MetropoliaMotorsport/Nodes/README.md

# Nodes
New Power + Analog nodes for HPF24
