MetropoliaMotorsport/Nodes/Datasheet_Nodes/size1.png

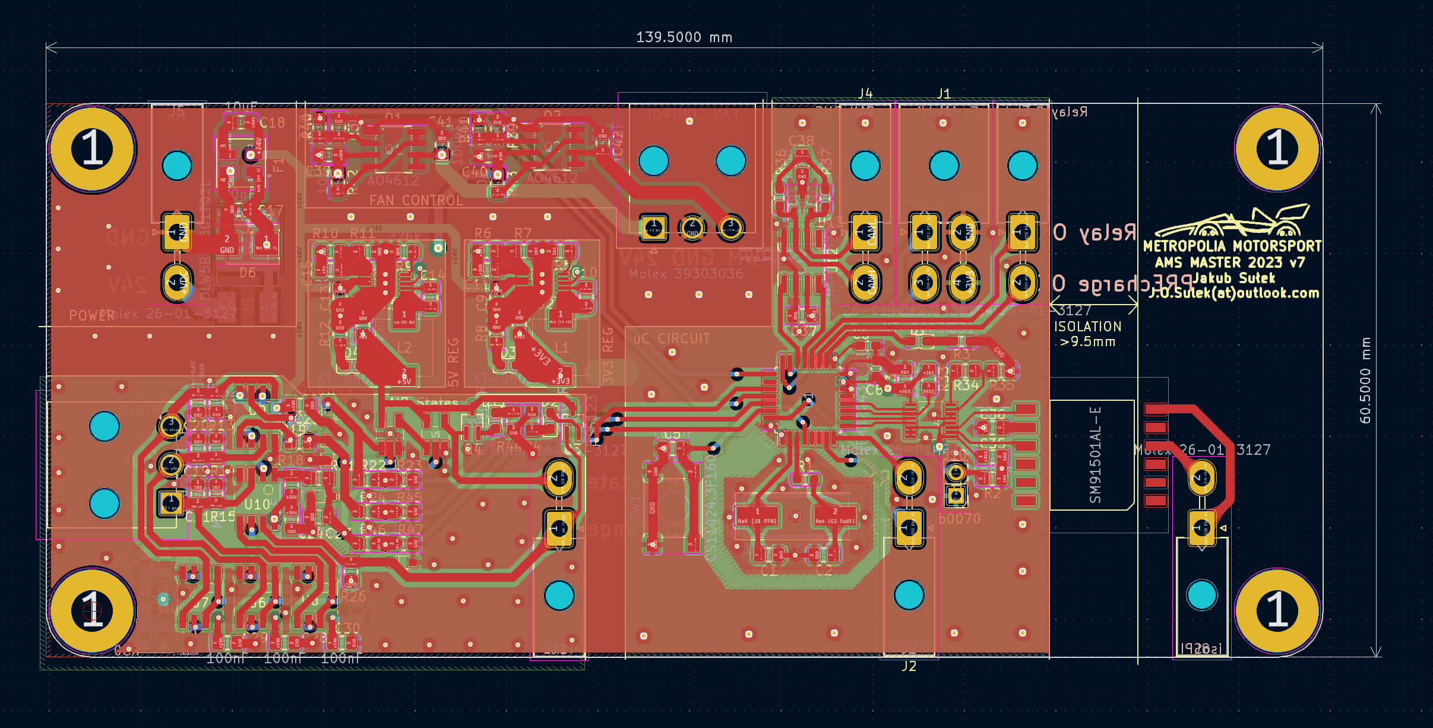
Datasheet_Nodes/size1.png
