MetropoliaMotorsport/Nodes/Datasheet_Nodes/size2.png

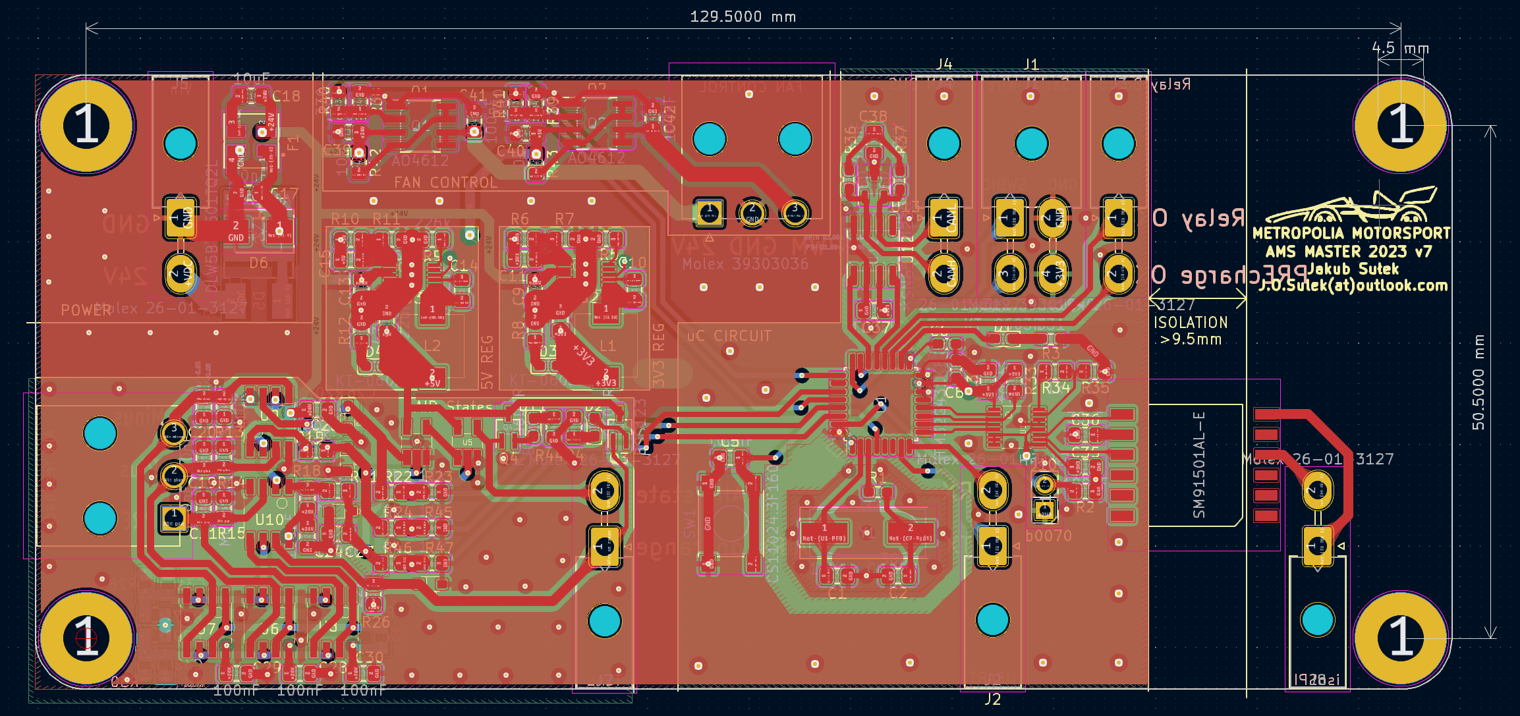
Datasheet_Nodes/size2.png
