MetropoliaMotorsport/Nodes/Nodes/Nodes.kicad_pcb

## KiCad design Nodes/Nodes.kicad_pcb (2024-12-06)

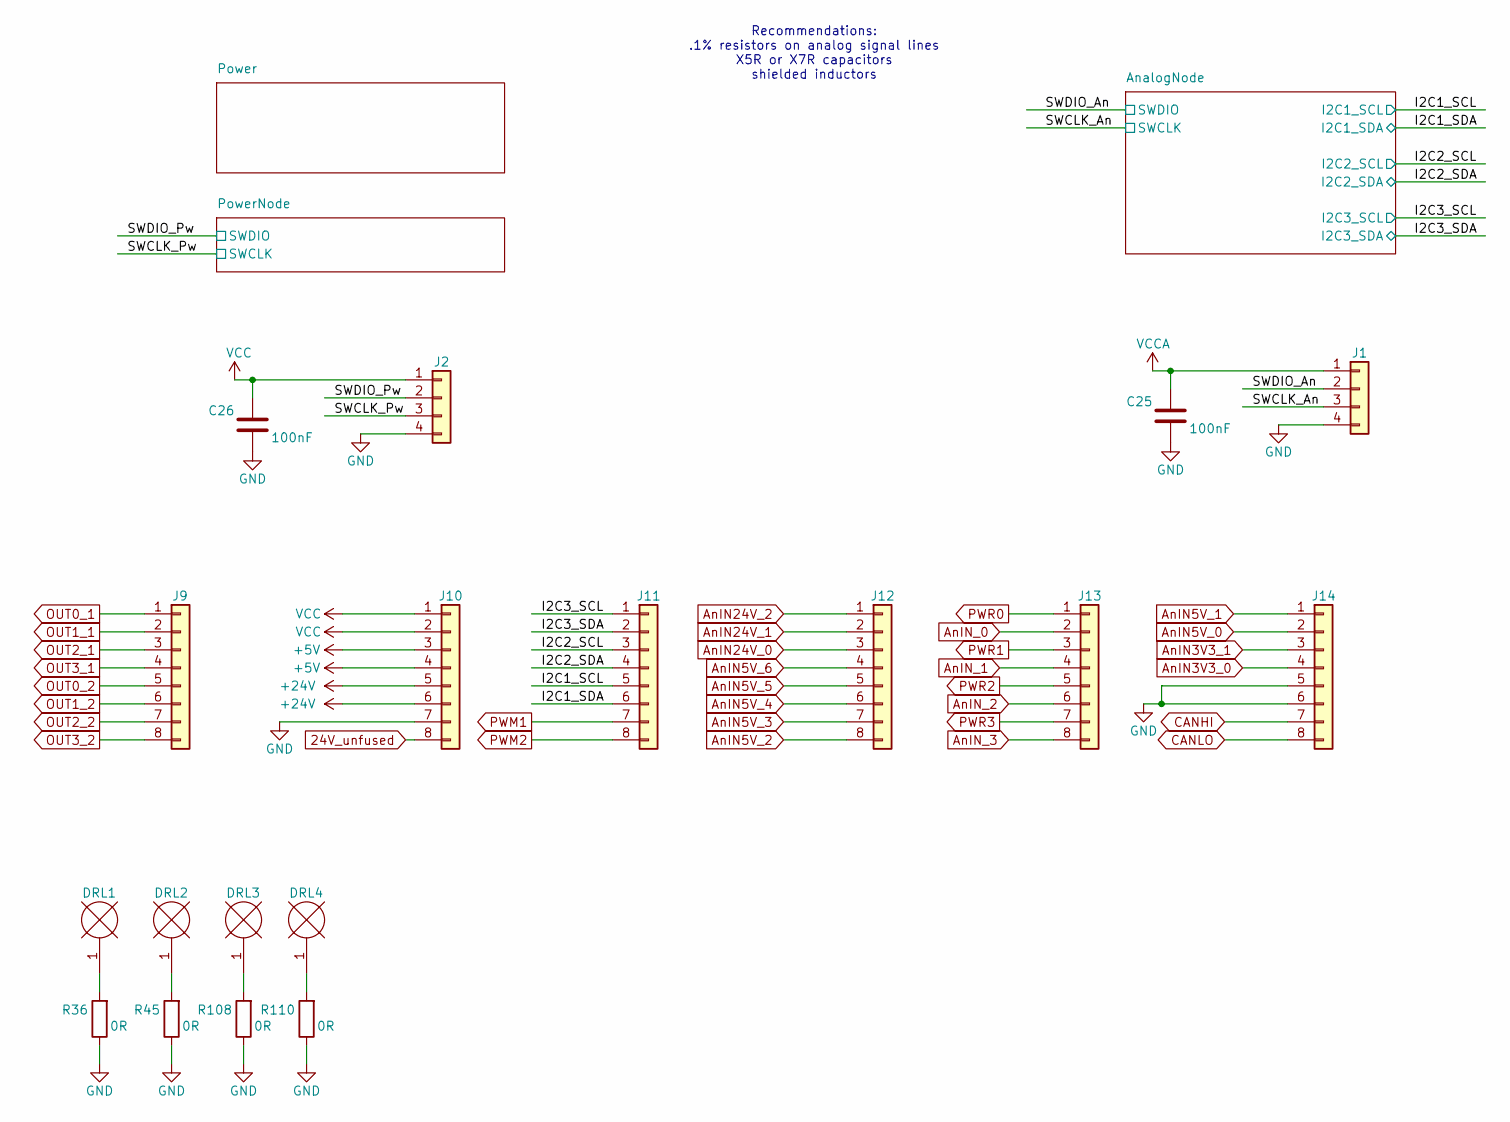
[picture p48: schematic Nodes.kicad_sch, Main]

Parts:
C25, C26: 100nF; C_0805_2012Metric_Pad1.18x1.45mm_HandSolder; TOLERANCE (FILL IN AS +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 10%
DRL1, DRL2, DRL3, DRL4: HOLE4.28.4; MountingHole_4.3mm_M4_Pad
J1, J2: Conn_01x04; PinSocket_1x04_P2.54mm_Vertical
J9, J10, J11, J12, J13, J14: Conn_01x08; PinHeader_1x08_P2.54mm_Vertical
R36, R45, R108, R110: 0R; R_0805_2012Metric_Pad1.20x1.40mm_HandSolder

Connections:
24V_unfused: J10.8; also elsewhere on the board
+5V: J10.3, J10.4; also elsewhere on the board
+24V: J10.5, J10.6; also elsewhere on the board
/I2C1_SCL: J11.5; also elsewhere on the board
/I2C1_SDA: J11.6; also elsewhere on the board
/I2C2_SCL: J11.3; also elsewhere on the board
/I2C2_SDA: J11.4; also elsewhere on the board
/I2C3_SCL: J11.1; also elsewhere on the board
/I2C3_SDA: J11.2; also elsewhere on the board
/SWCLK_An: J1.3; also elsewhere on the board
/SWCLK_Pw: J2.3; also elsewhere on the board
/SWDIO_An: J1.2; also elsewhere on the board
/SWDIO_Pw: J2.2; also elsewhere on the board
AnIN3V3_0: J14.4; also elsewhere on the board
AnIN3V3_1: J14.3; also elsewhere on the board
AnIN5V_0: J14.2; also elsewhere on the board
AnIN5V_1: J14.1; also elsewhere on the board
AnIN5V_2: J12.8; also elsewhere on the board
AnIN5V_3: J12.7; also elsewhere on the board
AnIN5V_4: J12.6; also elsewhere on the board
AnIN5V_5: J12.5; also elsewhere on the board
AnIN5V_6: J12.4; also elsewhere on the board
AnIN24V_0: J12.3; also elsewhere on the board
AnIN24V_1: J12.2; also elsewhere on the board
AnIN24V_2: J12.1; also elsewhere on the board
AnIN_0: J13.2; also elsewhere on the board
AnIN_1: J13.4; also elsewhere on the board
AnIN_2: J13.6; also elsewhere on the board
AnIN_3: J13.8; also elsewhere on the board
CANHI: J14.7; also elsewhere on the board
CANLO: J14.8; also elsewhere on the board
GND: C25.2, C26.2, J1.4, J2.4, J10.7, J14.5, J14.6, R36.1, R45.1, R108.1, R110.1; also elsewhere on the board
unnamed: DRL1.1, R36.2
unnamed: DRL2.1, R45.2
unnamed: DRL3.1, R108.2
unnamed: DRL4.1, R110.2
OUT0_1: J9.1; also elsewhere on the board
OUT0_2: J9.5; also elsewhere on the board
OUT1_1: J9.2; also elsewhere on the board
OUT1_2: J9.6; also elsewhere on the board
OUT2_1: J9.3; also elsewhere on the board
OUT2_2: J9.7; also elsewhere on the board
OUT3_1: J9.4; also elsewhere on the board
OUT3_2: J9.8; also elsewhere on the board
PWM1: J11.7; also elsewhere on the board
PWM2: J11.8; also elsewhere on the board
PWR0: J13.1; also elsewhere on the board
PWR1: J13.3; also elsewhere on the board
PWR2: J13.5; also elsewhere on the board
PWR3: J13.7; also elsewhere on the board
VCC: C26.1, J2.1, J10.1, J10.2; also elsewhere on the board
VCCA: C25.1, J1.1; also elsewhere on the board

Notes on the sheet:
Recommendations: .1% resistors on analog signal lines X5R or X7R capacitors shielded inductors
${REVISION}

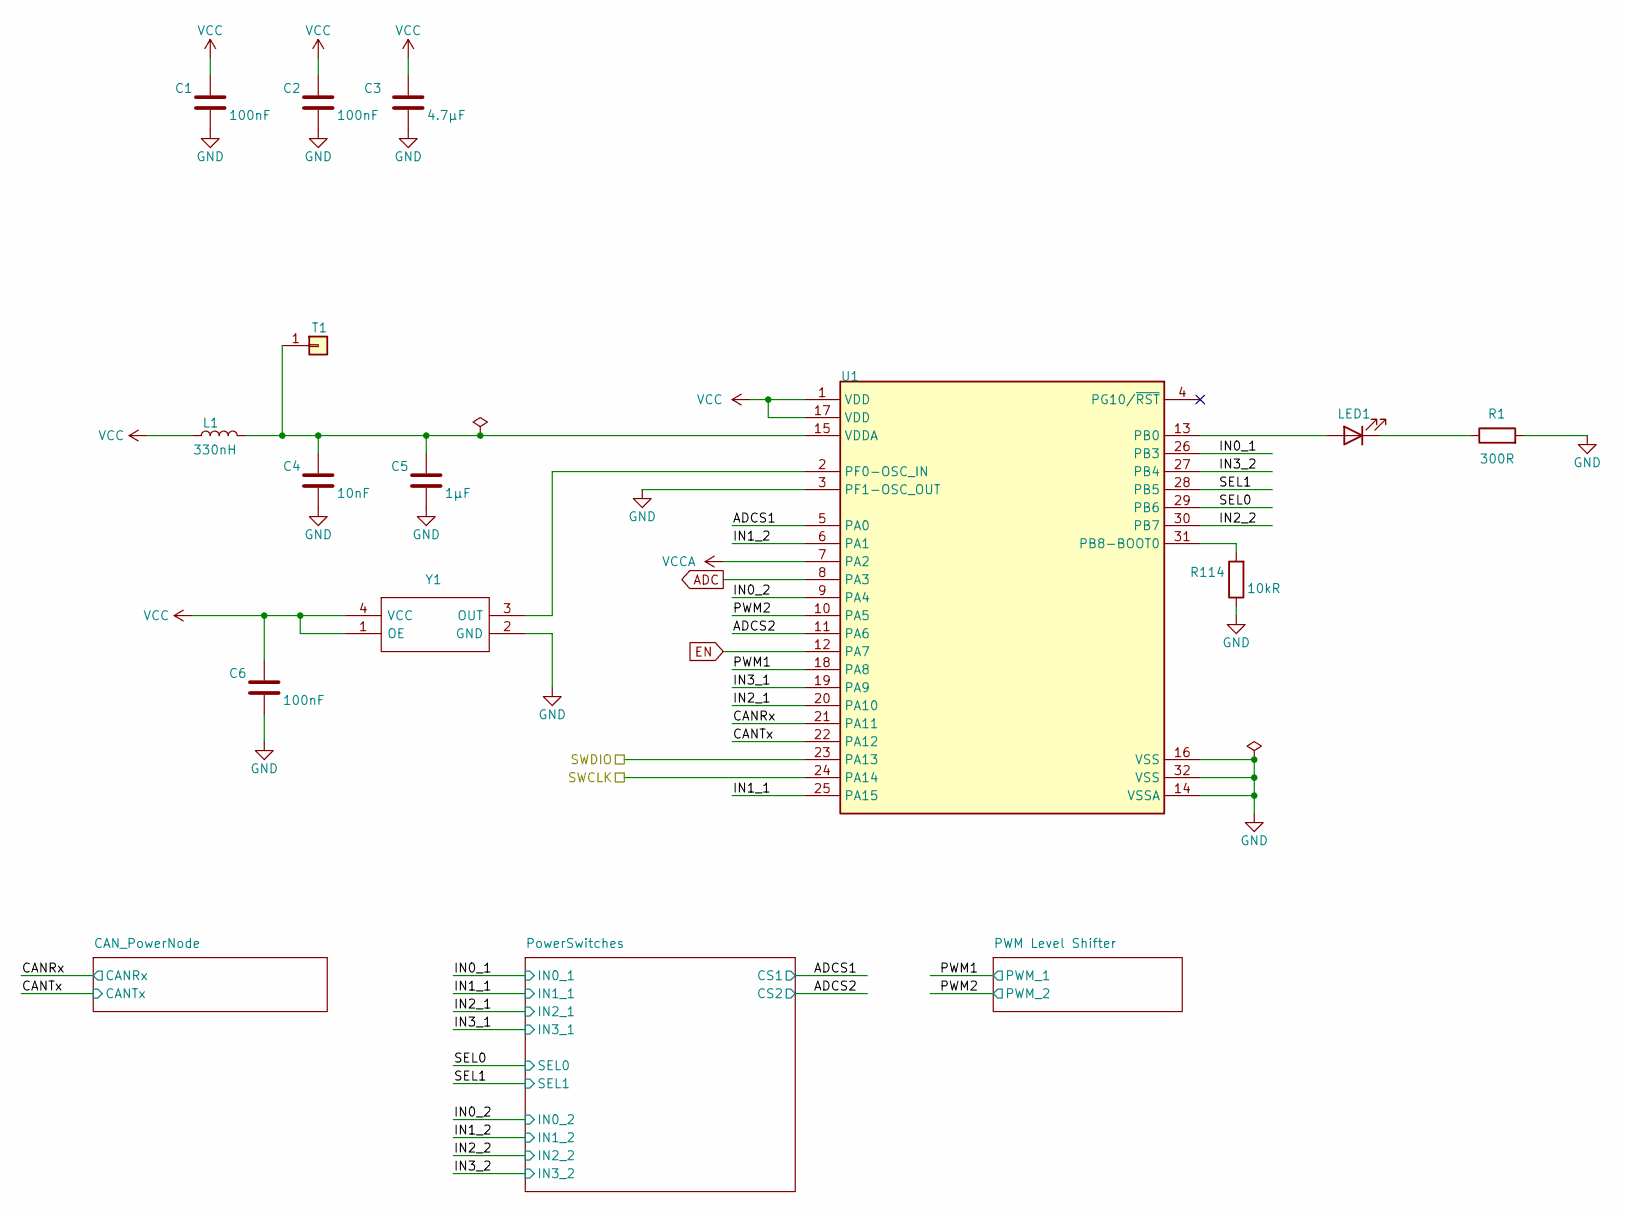
[picture p49: schematic PowerNode.kicad_sch, Power Node]

Parts:
C1, C2, C6: 100nF; C_0805_2012Metric_Pad1.18x1.45mm_HandSolder; TOLERANCE (FILL IN AS +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 10%
C3: 4.7µF; C_0805_2012Metric_Pad1.18x1.45mm_HandSolder; TOLERANCE (FILL IN AS +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 10%
C4: 10nF; C_0805_2012Metric_Pad1.18x1.45mm_HandSolder; TOLERANCE (FILL IN AS +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 10%
C5: 1µF; C_0805_2012Metric_Pad1.18x1.45mm_HandSolder; TOLERANCE (FILL IN AS +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 10%
L1: 330nH; L_0805_2012Metric_Pad1.15x1.40mm_HandSolder; TOLERANCE 20%
LED1: SML-210VTT86; LED_0805_2012Metric_Pad1.15x1.40mm_HandSolder; FORWARD VOLTAGE 2V; REVERSE VOLTAGE 4V; MANUFACTURER PART NUMBER SML-210VTT86; MOUSER DESCRIPTION Standard LEDs - SMD RED SMD TRANS LENS
R1: 300R; R_0805_2012Metric_Pad1.20x1.40mm_HandSolder; POWER RATING 400mW; TOLERANCE 5%
R114: 10kR; R_0805_2012Metric_Pad1.20x1.40mm_HandSolder
T1: Conn_01x01; TestPoint_THTPad_D1.5mm_Drill0.7mm
U1: STM32G431KBT6; FP-LQFP32-5V-IPC_B
Y1: SG-8018CE_8.0000M-TJHPA3; SG8018CE80000MTJHPA3; Mouser Part Number 732-CE8M-TJHPA3

Connections:
/PowerNode/ADCS1: U1.5 (PA0); also elsewhere on the board
/PowerNode/ADCS2: U1.11 (PA6); also elsewhere on the board
/PowerNode/CANRx: U1.21 (PA11); also elsewhere on the board
/PowerNode/CANTx: U1.22 (PA12); also elsewhere on the board
/PowerNode/IN0_1: U1.26 (PB3); also elsewhere on the board
/PowerNode/IN0_2: U1.9 (PA4); also elsewhere on the board
/PowerNode/IN1_1: U1.25 (PA15); also elsewhere on the board
/PowerNode/IN1_2: U1.6 (PA1); also elsewhere on the board
/PowerNode/IN2_1: U1.20 (PA10); also elsewhere on the board
/PowerNode/IN2_2: U1.30 (PB7); also elsewhere on the board
/PowerNode/IN3_1: U1.19 (PA9); also elsewhere on the board
/PowerNode/IN3_2: U1.27 (PB4); also elsewhere on the board
/PowerNode/PWM1: U1.18 (PA8); also elsewhere on the board
/PowerNode/PWM2: U1.10 (PA5); also elsewhere on the board
/PowerNode/SEL0: U1.29 (PB6); also elsewhere on the board
/PowerNode/SEL1: U1.28 (PB5); also elsewhere on the board
/SWCLK_Pw: U1.24 (PA14); also elsewhere on the board
/SWDIO_Pw: U1.23 (PA13); also elsewhere on the board
ADC: U1.8 (PA3); also elsewhere on the board
EN: U1.12 (PA7); also elsewhere on the board
GND: C1.2, C2.2, C3.2, C4.2, C5.2, C6.2, R1.2, R114.1, U1.3 (PF1-OSC_OUT), U1.14 (VSSA), U1.16 (VSS), U1.32 (VSS), Y1.2 (GND); also elsewhere on the board
unnamed: LED1.2 (A), U1.13 (PB0)
unnamed: LED1.1 (K), R1.1
unnamed: C4.1, C5.1, L1.2, T1.1, U1.15 (VDDA)
unnamed: R114.2, U1.31 (PB8-BOOT0)
unnamed: U1.2 (PF0-OSC_IN), Y1.3 (OUT)
VCC: C1.1, C2.1, C3.1, C6.1, L1.1, U1.1 (VDD), U1.17 (VDD), Y1.1 (OE), Y1.4 (VCC); also elsewhere on the board
VCCA: U1.7 (PA2); also elsewhere on the board

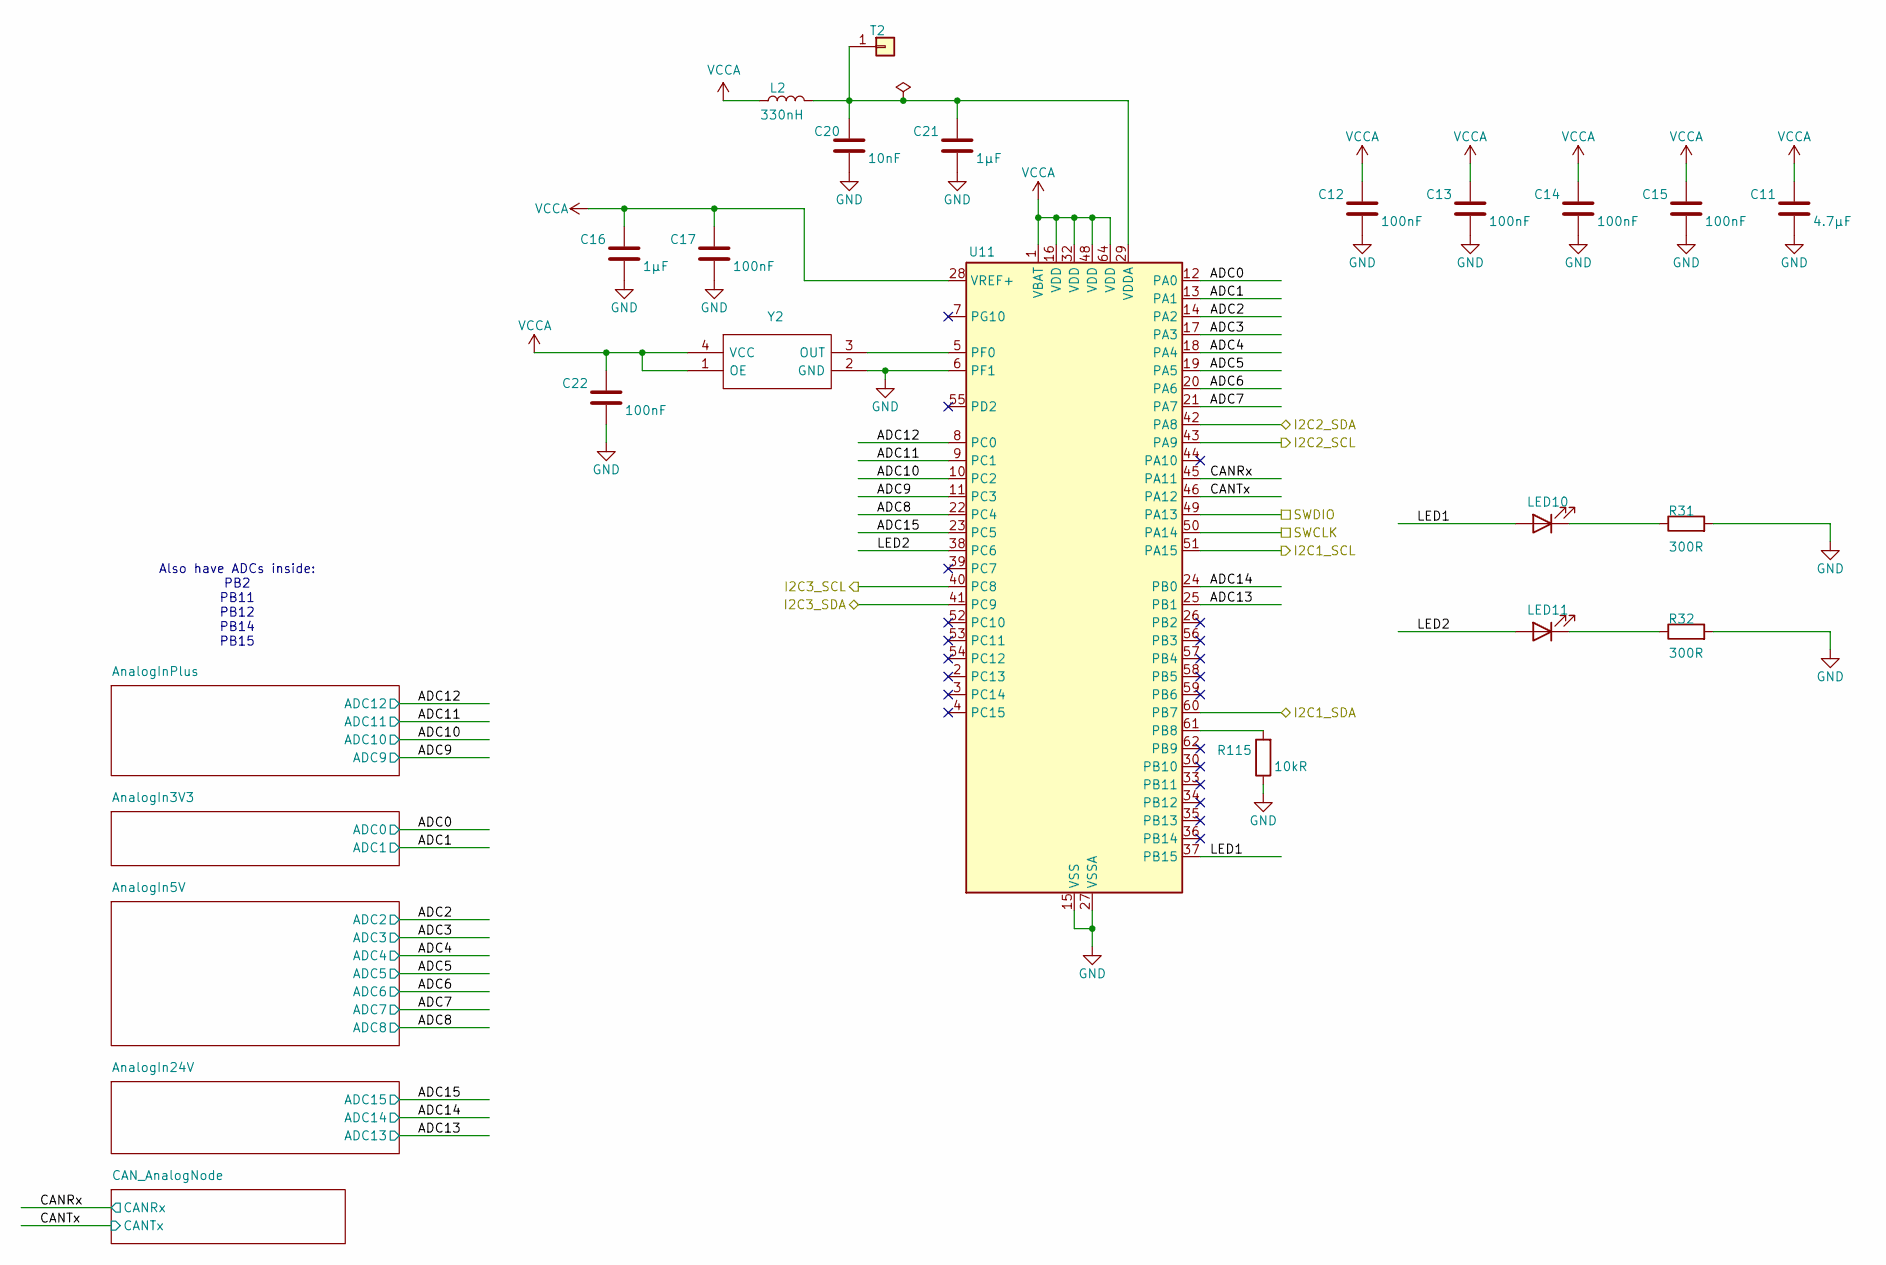
[picture p50: schematic AnalogNode.kicad_sch, Analog Node]

Parts:
C11: 4.7µF; C_0805_2012Metric_Pad1.18x1.45mm_HandSolder; TOLERANCE (FILL IN AS +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 10%
C12, C13, C14, C15, C17, C22: 100nF; C_0805_2012Metric_Pad1.18x1.45mm_HandSolder; TOLERANCE (FILL IN AS +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 10%
C16, C21: 1µF; C_0805_2012Metric_Pad1.18x1.45mm_HandSolder; TOLERANCE (FILL IN AS +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 10%
C20: 10nF; C_0805_2012Metric_Pad1.18x1.45mm_HandSolder; TOLERANCE (FILL IN AS +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 10%
L2: 330nH; L_0805_2012Metric_Pad1.15x1.40mm_HandSolder; TOLERANCE 20%
LED10, LED11: SML-210VTT86; LED_0805_2012Metric_Pad1.15x1.40mm_HandSolder; FORWARD VOLTAGE 2V; REVERSE VOLTAGE 4V; MANUFACTURER PART NUMBER SML-210VTT86; MOUSER DESCRIPTION Standard LEDs - SMD RED SMD TRANS LENS
R31, R32: 300R; R_0805_2012Metric_Pad1.20x1.40mm_HandSolder; POWER RATING 400mW; TOLERANCE 5%
R115: 10kR; R_0805_2012Metric_Pad1.20x1.40mm_HandSolder
T2: Conn_01x01; TestPoint_THTPad_D1.5mm_Drill0.7mm
U11: STM32G431RBTx; LQFP-64_10x10mm_P0.5mm
Y2: SG-8018CE_8.0000M-TJHPA3; SG8018CE80000MTJHPA3; Mouser Part Number 732-CE8M-TJHPA3

Connections:
/AnalogNode/ADC0: U11.12 (PA0); also elsewhere on the board
/AnalogNode/ADC1: U11.13 (PA1); also elsewhere on the board
/AnalogNode/ADC2: U11.14 (PA2); also elsewhere on the board
/AnalogNode/ADC3: U11.17 (PA3); also elsewhere on the board
/AnalogNode/ADC4: U11.18 (PA4); also elsewhere on the board
/AnalogNode/ADC5: U11.19 (PA5); also elsewhere on the board
/AnalogNode/ADC6: U11.20 (PA6); also elsewhere on the board
/AnalogNode/ADC7: U11.21 (PA7); also elsewhere on the board
/AnalogNode/ADC8: U11.22 (PC4); also elsewhere on the board
/AnalogNode/ADC9: U11.11 (PC3); also elsewhere on the board
/AnalogNode/ADC10: U11.10 (PC2); also elsewhere on the board
/AnalogNode/ADC11: U11.9 (PC1); also elsewhere on the board
/AnalogNode/ADC12: U11.8 (PC0); also elsewhere on the board
/AnalogNode/ADC13: U11.25 (PB1); also elsewhere on the board
/AnalogNode/ADC14: U11.24 (PB0); also elsewhere on the board
/AnalogNode/ADC15: U11.23 (PC5); also elsewhere on the board
/AnalogNode/CANRx: U11.45 (PA11); also elsewhere on the board
/AnalogNode/CANTx: U11.46 (PA12); also elsewhere on the board
/AnalogNode/LED1: LED10.2 (A), U11.37 (PB15)
/AnalogNode/LED2: LED11.2 (A), U11.38 (PC6)
/I2C1_SCL: U11.51 (PA15); also elsewhere on the board
/I2C1_SDA: U11.60 (PB7); also elsewhere on the board
/I2C2_SCL: U11.43 (PA9); also elsewhere on the board
/I2C2_SDA: U11.42 (PA8); also elsewhere on the board
/I2C3_SCL: U11.40 (PC8); also elsewhere on the board
/I2C3_SDA: U11.41 (PC9); also elsewhere on the board
/SWCLK_An: U11.50 (PA14); also elsewhere on the board
/SWDIO_An: U11.49 (PA13); also elsewhere on the board
GND: C11.2, C12.2, C13.2, C14.2, C15.2, C16.2, C17.2, C20.2, C21.2, C22.2, R31.2, R32.2, R115.1, U11.6 (PF1), U11.15 (VSS), U11.27 (VSSA), U11.31 (VSS), U11.47 (VSS), U11.63 (VSS), Y2.2 (GND); also elsewhere on the board
unnamed: LED10.1 (K), R31.1
unnamed: LED11.1 (K), R32.1
unnamed: C20.1, C21.1, L2.2, T2.1, U11.29 (VDDA)
unnamed: R115.2, U11.61 (PB8)
unnamed: U11.5 (PF0), Y2.3 (OUT)
VCCA: C11.1, C12.1, C13.1, C14.1, C15.1, C16.1, C17.1, C22.1, L2.1, U11.1 (VBAT), U11.16 (VDD), U11.28 (VREF+), U11.32 (VDD), U11.48 (VDD), U11.64 (VDD), Y2.1 (OE), Y2.4 (VCC); also elsewhere on the board

Notes on the sheet:
Also have ADCs inside: PB2 PB11 PB12 PB14 PB15

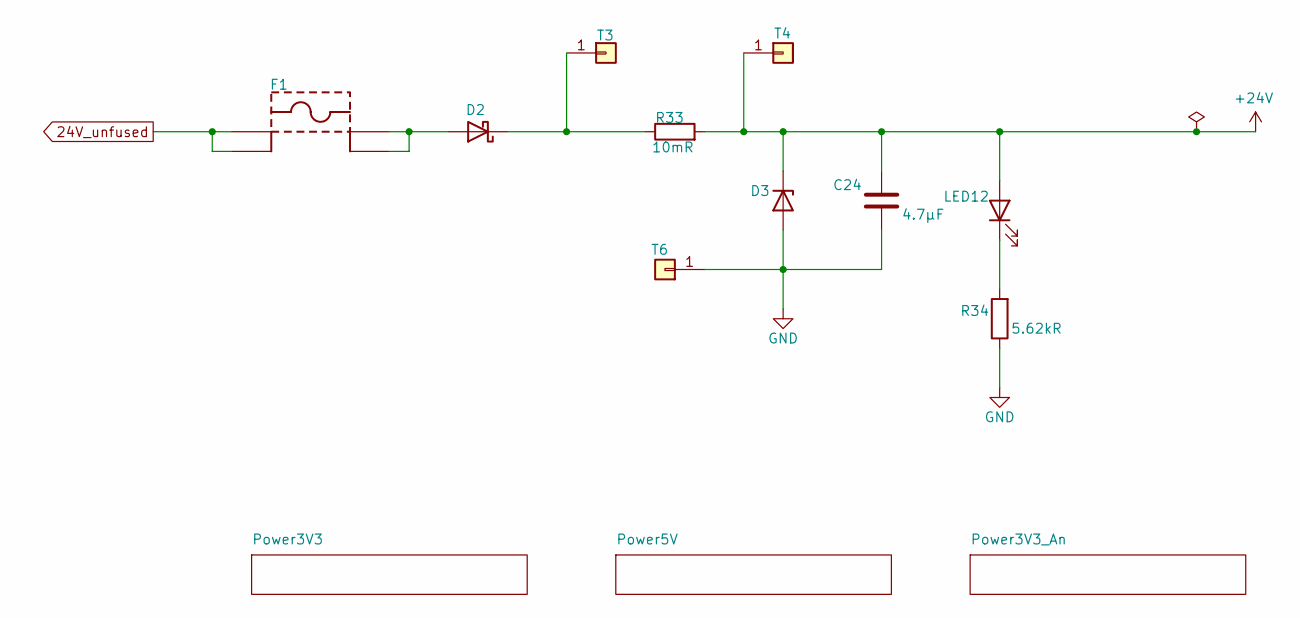
[picture p51: schematic Power.kicad_sch]

Parts:
C24: 4.7µF; C_0805_2012Metric_Pad1.18x1.45mm_HandSolder; TOLERANCE (FILL IN AS +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 10%
D2: SX33L_R1_00001; D_SMA_Handsoldering
D3: 1SMA5934BT3G; D_SMA_Handsoldering; PARTNUMBER 1SMA5934BT3G
F1: 3557-2; KSTN-3557-2; VOLTAGE 500V; CURRENT RATING 30A
LED12: SMLMN2WB1CW1; LED_0805_2012Metric_Pad1.15x1.40mm_HandSolder; MANUFACTURER_PART_NUMBER SMLMN2WB1CW1; MOUSER PART NUMBER 755-SMLMN2WB1CW1C
R33: 10mR; R_0805_2012Metric_Pad1.20x1.40mm_HandSolder; TOLERANCE 1%
R34: 5.62kR; R_0805_2012Metric_Pad1.20x1.40mm_HandSolder
T3, T4, T6: Conn_01x01; TestPoint_THTPad_D1.5mm_Drill0.7mm

Connections:
24V_unfused: F1.1, F1.2; also elsewhere on the board
+24V: C24.1, D3.1 (K), LED12.2 (A), R33.2, T4.1; also elsewhere on the board
GND: C24.2, D3.2 (A), R34.1, T6.1; also elsewhere on the board
unnamed: D2.2 (A), F1.3, F1.4
unnamed: D2.1 (K), R33.1, T3.1
unnamed: LED12.1 (K), R34.2

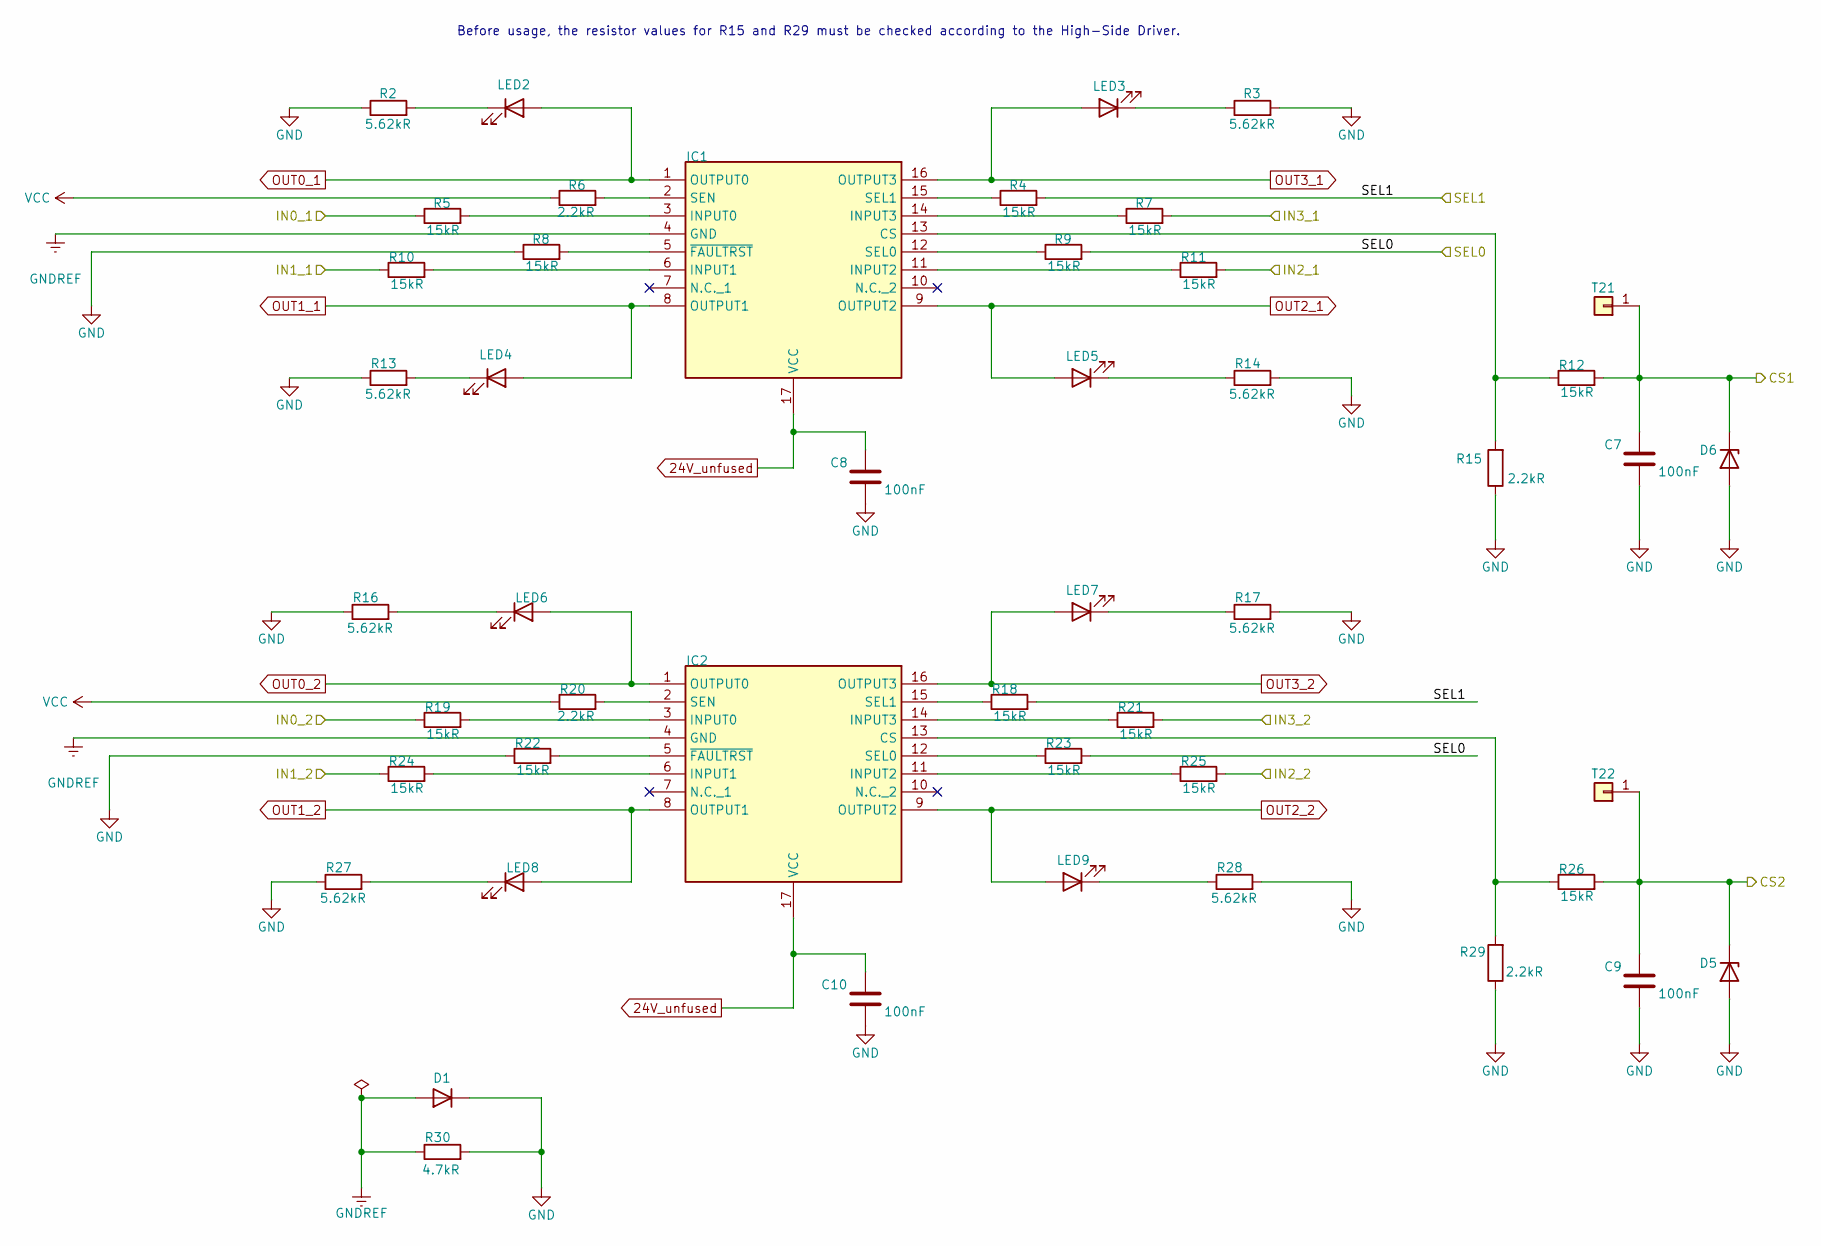
[picture p52: schematic PowerSwitches.kicad_sch, Power Switches]

Parts:
C7, C8, C9, C10: 100nF; C_0805_2012Metric_Pad1.18x1.45mm_HandSolder; TOLERANCE (FILL IN AS +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 10%
D1: S1M-13-F; D_SMA_Handsoldering; FORWARD VOLTAGE 1.1V
D5, D6: 1SMA5913BT3G; D_SMA_Handsoldering
IC1, IC2: VNQ9025AJTR; SOP50P600X170-17N; MANUFACTURER_PART_NUMBER VNQ9025AJTR; MOUSER PART NUMBER 511-VNQ9025AJTR
LED2, LED6: SML-H12D8TT86; LED_0805_2012Metric_Pad1.15x1.40mm_HandSolder; MANUFACTURER_PART_NUMBER SML-H12D8TT86; MOUSER PART NUMBER 755-SML-H12D8TT86
LED3, LED7: 150080BS75000; LED_0805_2012Metric_Pad1.15x1.40mm_HandSolder; MANUFACTURER_PART_NUMBER SZYY0805B
LED4, LED8: SML-210YTT86M; LED_0805_2012Metric_Pad1.15x1.40mm_HandSolder; MANUFACTURER_PART_NUMBER SML-210YTT86M
LED5, LED9: SML-H12P8TT86; LED_0805_2012Metric_Pad1.15x1.40mm_HandSolder; MANUFACTURER_PART_NUMBER SML-H12P8TT86; MOUSER PART NUMBER 755-SML-H12P8TT86
R2, R3, R13, R14, R16, R17, R27, R28: 5.62kR; R_0805_2012Metric_Pad1.20x1.40mm_HandSolder
R4, R5, R7, R8, R9, R10, R11, R12, R18, R19, R21, R22, R23, R24, R25, R26: 15kR; R_0805_2012Metric_Pad1.20x1.40mm_HandSolder; TOLERANCE 0.25%; WORKING VOLTAGE 150V
R6, R15, R20, R29: 2.2kR; R_0805_2012Metric_Pad1.20x1.40mm_HandSolder; TOLERANCE 1%; WORKING VOLTAGE 150V
R30: 4.7kR; R_0805_2012Metric_Pad1.20x1.40mm_HandSolder; TOLERANCE 0.5%; WORKING VOLTAGE 150V
T21, T22: Conn_01x01; TestPoint_THTPad_D1.5mm_Drill0.7mm

Connections:
24V_unfused: C8.1, C10.1, IC1.17 (VCC), IC2.17 (VCC); also elsewhere on the board
/PowerNode/ADCS1: C7.1, D6.1 (K), R12.2, T21.1; also elsewhere on the board
/PowerNode/ADCS2: C9.1, D5.1 (K), R26.2, T22.1; also elsewhere on the board
/PowerNode/IN0_1: R5.1; also elsewhere on the board
/PowerNode/IN0_2: R19.1; also elsewhere on the board
/PowerNode/IN1_1: R10.1; also elsewhere on the board
/PowerNode/IN1_2: R24.1; also elsewhere on the board
/PowerNode/IN2_1: R11.2; also elsewhere on the board
/PowerNode/IN2_2: R25.2; also elsewhere on the board
/PowerNode/IN3_1: R7.2; also elsewhere on the board
/PowerNode/IN3_2: R21.2; also elsewhere on the board
/PowerNode/SEL0: R9.2, R23.2; also elsewhere on the board
/PowerNode/SEL1: R4.2, R18.2; also elsewhere on the board
GND: C7.2, C8.2, C9.2, C10.2, D1.1 (K), D5.2 (A), D6.2 (A), R2.1, R3.2, R8.1, R13.1, R14.2, R15.1, R16.1, R17.2, R22.1, R27.1, R28.2, R29.1, R30.2; also elsewhere on the board
GNDREF: D1.2 (A), IC1.4 (GND), IC2.4 (GND), R30.1
unnamed: IC1.13 (CS), R12.1, R15.2
unnamed: IC1.3 (INPUT0), R5.2
unnamed: IC1.6 (INPUT1), R10.2
unnamed: IC1.11 (INPUT2), R11.1
unnamed: IC1.14 (INPUT3), R7.1
unnamed: IC1.12 (SEL0), R9.1
unnamed: IC1.15 (SEL1), R4.1
unnamed: IC1.2 (SEN), R6.2
unnamed: IC1.5 (~FAULTRST), R8.2
unnamed: IC2.13 (CS), R26.1, R29.2
unnamed: IC2.3 (INPUT0), R19.2
unnamed: IC2.6 (INPUT1), R24.2
unnamed: IC2.11 (INPUT2), R25.1
unnamed: IC2.14 (INPUT3), R21.1
unnamed: IC2.12 (SEL0), R23.1
unnamed: IC2.15 (SEL1), R18.1
unnamed: IC2.2 (SEN), R20.2
unnamed: IC2.5 (~FAULTRST), R22.2
unnamed: LED2.1 (K), R2.2
unnamed: LED3.1 (K), R3.1
unnamed: LED4.1 (K), R13.2
unnamed: LED5.1 (K), R14.1
unnamed: LED6.1 (K), R16.2
unnamed: LED7.1 (K), R17.1
unnamed: LED8.1 (K), R27.2
unnamed: LED9.1 (K), R28.1
OUT0_1: IC1.1 (OUTPUT0), LED2.2 (A); also elsewhere on the board
OUT0_2: IC2.1 (OUTPUT0), LED6.2 (A); also elsewhere on the board
OUT1_1: IC1.8 (OUTPUT1), LED4.2 (A); also elsewhere on the board
OUT1_2: IC2.8 (OUTPUT1), LED8.2 (A); also elsewhere on the board
OUT2_1: IC1.9 (OUTPUT2), LED5.2 (A); also elsewhere on the board
OUT2_2: IC2.9 (OUTPUT2), LED9.2 (A); also elsewhere on the board
OUT3_1: IC1.16 (OUTPUT3), LED3.2 (A); also elsewhere on the board
OUT3_2: IC2.16 (OUTPUT3), LED7.2 (A); also elsewhere on the board
VCC: R6.1, R20.1; also elsewhere on the board

Notes on the sheet:
Before usage, the resistor values for R15 and R29   must be checked according to the High-Side Driver.

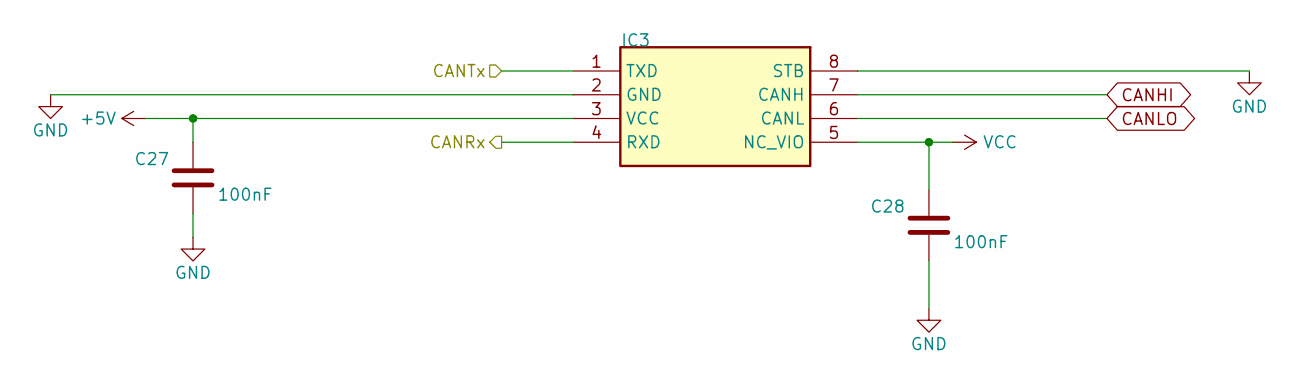
[picture p53: schematic CAN_PowerNode.kicad_sch, CAN for Power Node]

Parts:
C27, C28: 100nF; C_0805_2012Metric_Pad1.18x1.45mm_HandSolder; TOLERANCE (FILL IN AS +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 10%
IC3: TCAN1462VDRQ1; SOIC127P600X175-8N; MANUFACTURER_PART_NUMBER TCAN1462VDRQ1; MOUSER PART NUMBER 595-TCAN1462VDRQ1

Connections:
+5V: C27.1, IC3.3 (VCC); also elsewhere on the board
/PowerNode/CANRx: IC3.4 (RXD); also elsewhere on the board
/PowerNode/CANTx: IC3.1 (TXD); also elsewhere on the board
CANHI: IC3.7 (CANH); also elsewhere on the board
CANLO: IC3.6 (CANL); also elsewhere on the board
GND: C27.2, C28.2, IC3.2 (GND), IC3.8 (STB); also elsewhere on the board
VCC: C28.1, IC3.5 (NC_VIO); also elsewhere on the board

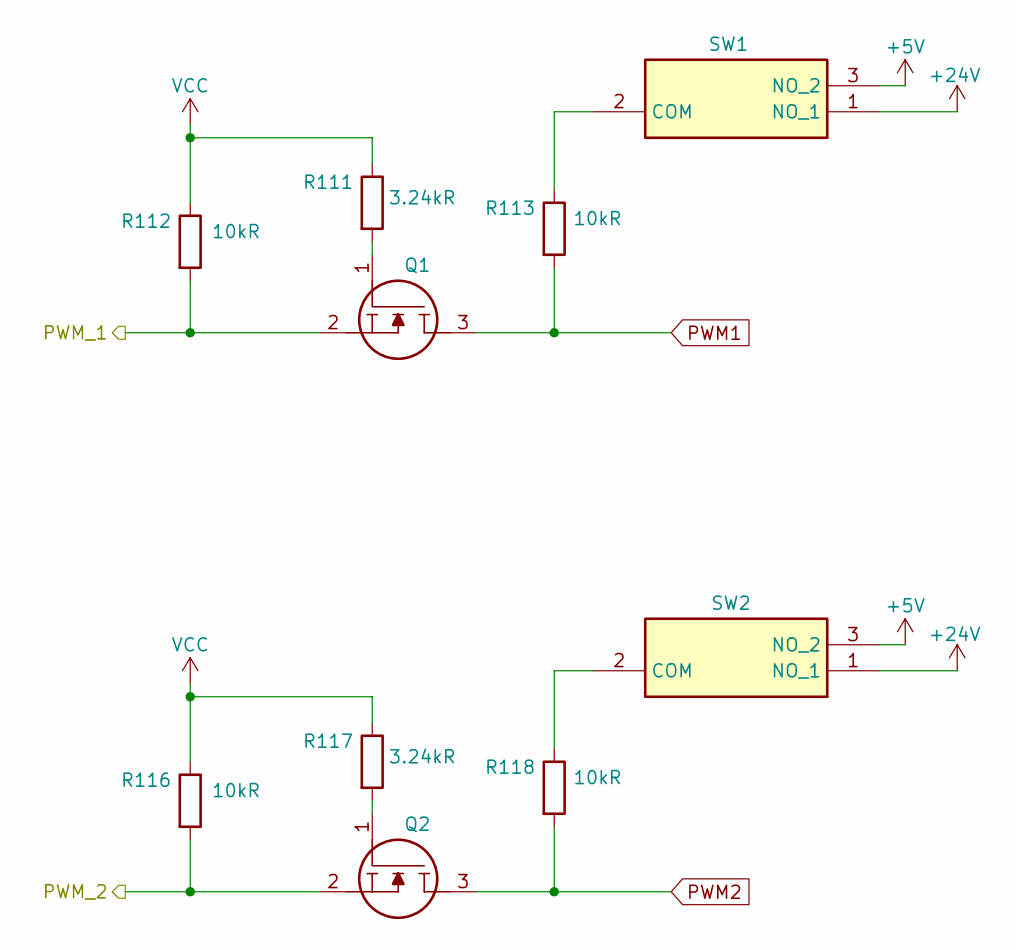
[picture p54: schematic PWM.kicad_sch, PWM Level Shifter]

Parts:
Q1, Q2: TN2106K1-G; SOT95P237X112-3N; Mouser Part Number 689-TN2106K1-G
R111, R117: 3.24kR; R_0805_2012Metric_Pad1.20x1.40mm_HandSolder
R112, R113, R116, R118: 10kR; R_0805_2012Metric_Pad1.20x1.40mm_HandSolder
SW1, SW2: CJS-1201TB1; CJS1201TB1; Mouser Part Number 229-CJS-1201TB1

Connections:
+5V: SW1.3 (NO_2), SW2.3 (NO_2); also elsewhere on the board
+24V: SW1.1 (NO_1), SW2.1 (NO_1); also elsewhere on the board
/PowerNode/PWM1: Q1.2, R112.2; also elsewhere on the board
/PowerNode/PWM2: Q2.2, R116.2; also elsewhere on the board
unnamed: Q1.1, R111.2
unnamed: Q2.1, R117.2
unnamed: R113.1, SW1.2 (COM)
unnamed: R118.1, SW2.2 (COM)
PWM1: Q1.3, R113.2; also elsewhere on the board
PWM2: Q2.3, R118.2; also elsewhere on the board
VCC: R111.1, R112.1, R116.1, R117.1; also elsewhere on the board

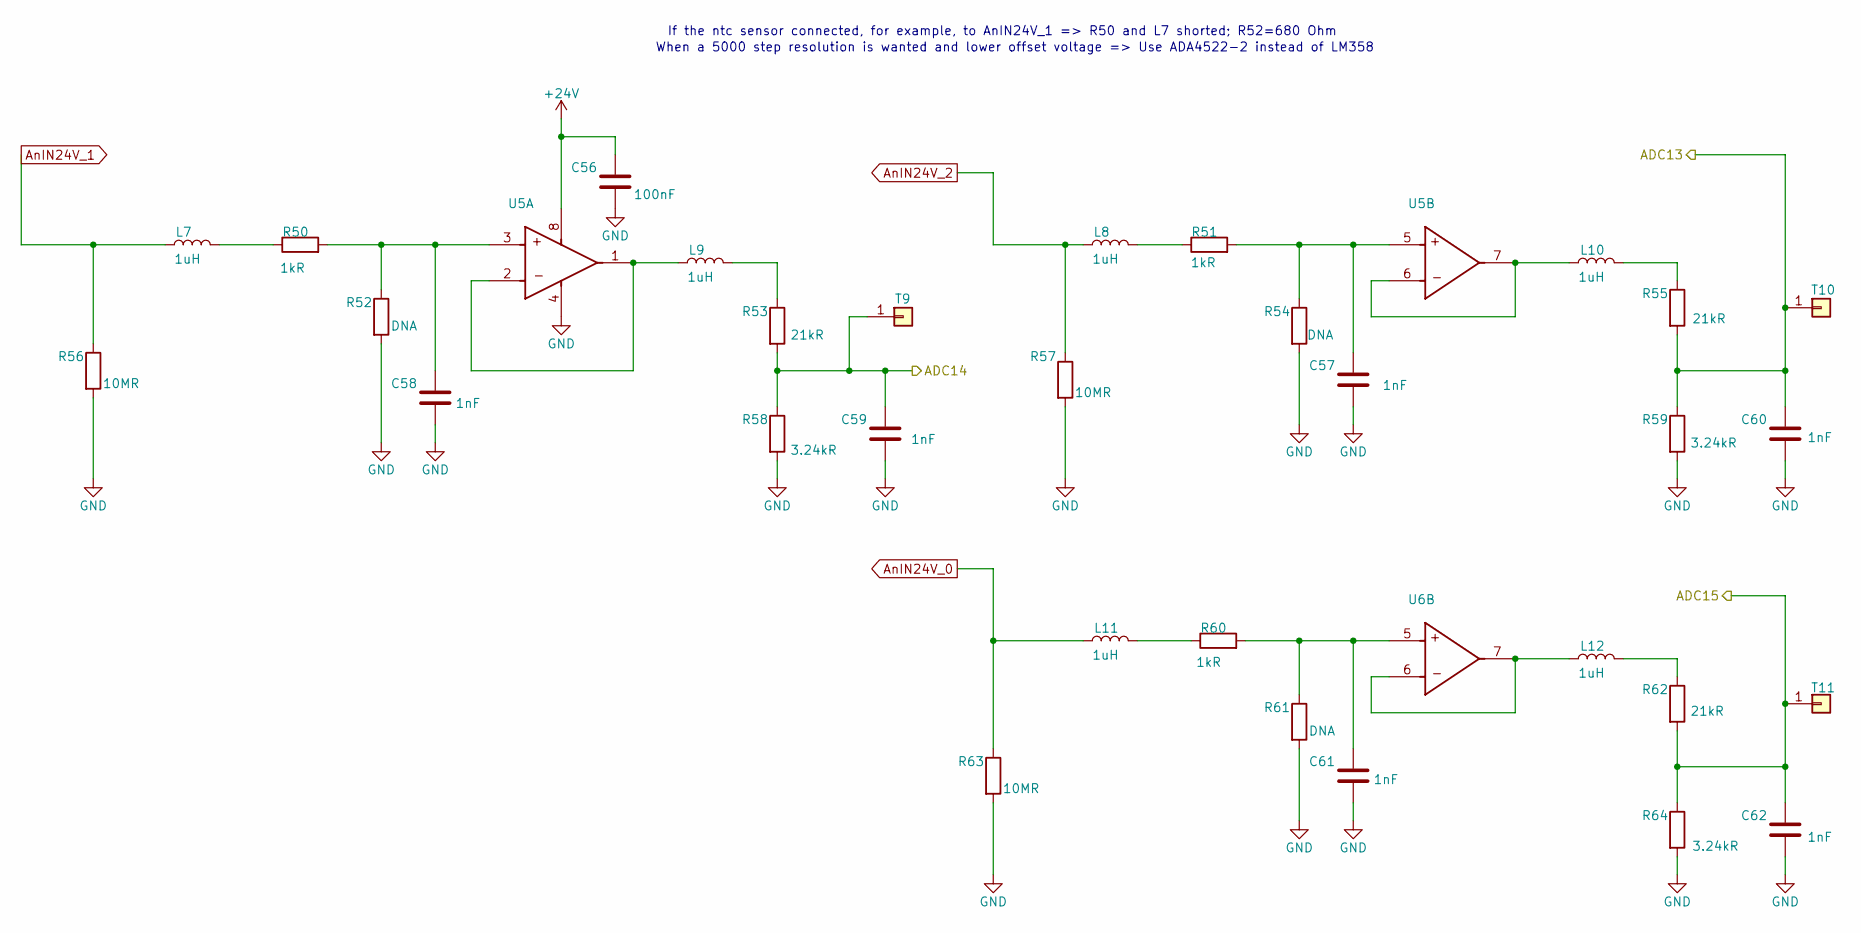
[picture p55: schematic AnalogIn24V.kicad_sch, Filters for 24V analog signal]

Parts:
C56: 100nF; C_0805_2012Metric_Pad1.18x1.45mm_HandSolder; TOLERANCE (FILL IN AS +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 10%
C57, C58, C59, C60, C61, C62: 1nF; C_0805_2012Metric_Pad1.18x1.45mm_HandSolder
L7, L8, L9, L10, L11, L12: 1uH; L_0805_2012Metric_Pad1.15x1.40mm_HandSolder; TOLERANCE 30%; CURRENT RATING 900mA
R50, R51, R60: 1kR; R_0805_2012Metric_Pad1.20x1.40mm_HandSolder
R52, R54, R61: DNA; R_0805_2012Metric_Pad1.20x1.40mm_HandSolder; PART NUMBER CRCW0805680RFKEA
R53, R55, R62: 21kR; R_0805_2012Metric_Pad1.20x1.40mm_HandSolder
R56, R57, R63: 10MR; R_0805_2012Metric_Pad1.20x1.40mm_HandSolder; POWER RATING 125mW; VOLTAGE RATING (DC) 150V
R58, R59, R64: 3.24kR; R_0805_2012Metric_Pad1.20x1.40mm_HandSolder
T9, T10, T11: Conn_01x01; TestPoint_THTPad_D1.5mm_Drill0.7mm
U5, U6: LM358BAIDR; FP-D0008A-IPC_A

Connections:
+24V: C56.1, U5.8 (V+); also elsewhere on the board
/AnalogNode/ADC13: C60.1, R55.2, R59.1, T10.1; also elsewhere on the board
/AnalogNode/ADC14: C59.1, R53.2, R58.1, T9.1; also elsewhere on the board
/AnalogNode/ADC15: C62.1, R62.2, R64.1, T11.1; also elsewhere on the board
AnIN24V_0: L11.1, R63.1; also elsewhere on the board
AnIN24V_1: L7.1, R56.1; also elsewhere on the board
AnIN24V_2: L8.1, R57.1; also elsewhere on the board
GND: C56.2, C57.2, C58.2, C59.2, C60.2, C61.2, C62.2, R52.2, R54.2, R56.2, R57.2, R58.2, R59.2, R61.2, R63.2, R64.2, U5.4 (V-); also elsewhere on the board
unnamed: L7.2, R50.1
unnamed: L8.2, R51.1
unnamed: L9.2, R53.1
unnamed: L10.2, R55.1
unnamed: L11.2, R60.1
unnamed: L12.2, R62.1
unnamed: C58.1, R50.2, R52.1, U5.3 (IN1+)
unnamed: L9.1, U5.1 (OUT1), U5.2 (IN1-)
unnamed: C57.1, R51.2, R54.1, U5.5 (IN2+)
unnamed: L10.1, U5.6 (IN2-), U5.7 (OUT2)
unnamed: C61.1, R60.2, R61.1, U6.5 (IN2+)
unnamed: L12.1, U6.6 (IN2-), U6.7 (OUT2)

Notes on the sheet:
When a 5000 step resolution is wanted and lower offset voltage => Use ADA4522-2 instead of LM358
If the ntc sensor connected, for example, to AnIN24V_1 => R50 and L7 shorted; R52=680 Ohm
