MetropoliaMotorsport/Nodes/Nodes/Nodes.kicad_pcb

## KiCad design Nodes/Nodes.kicad_pcb (continued)

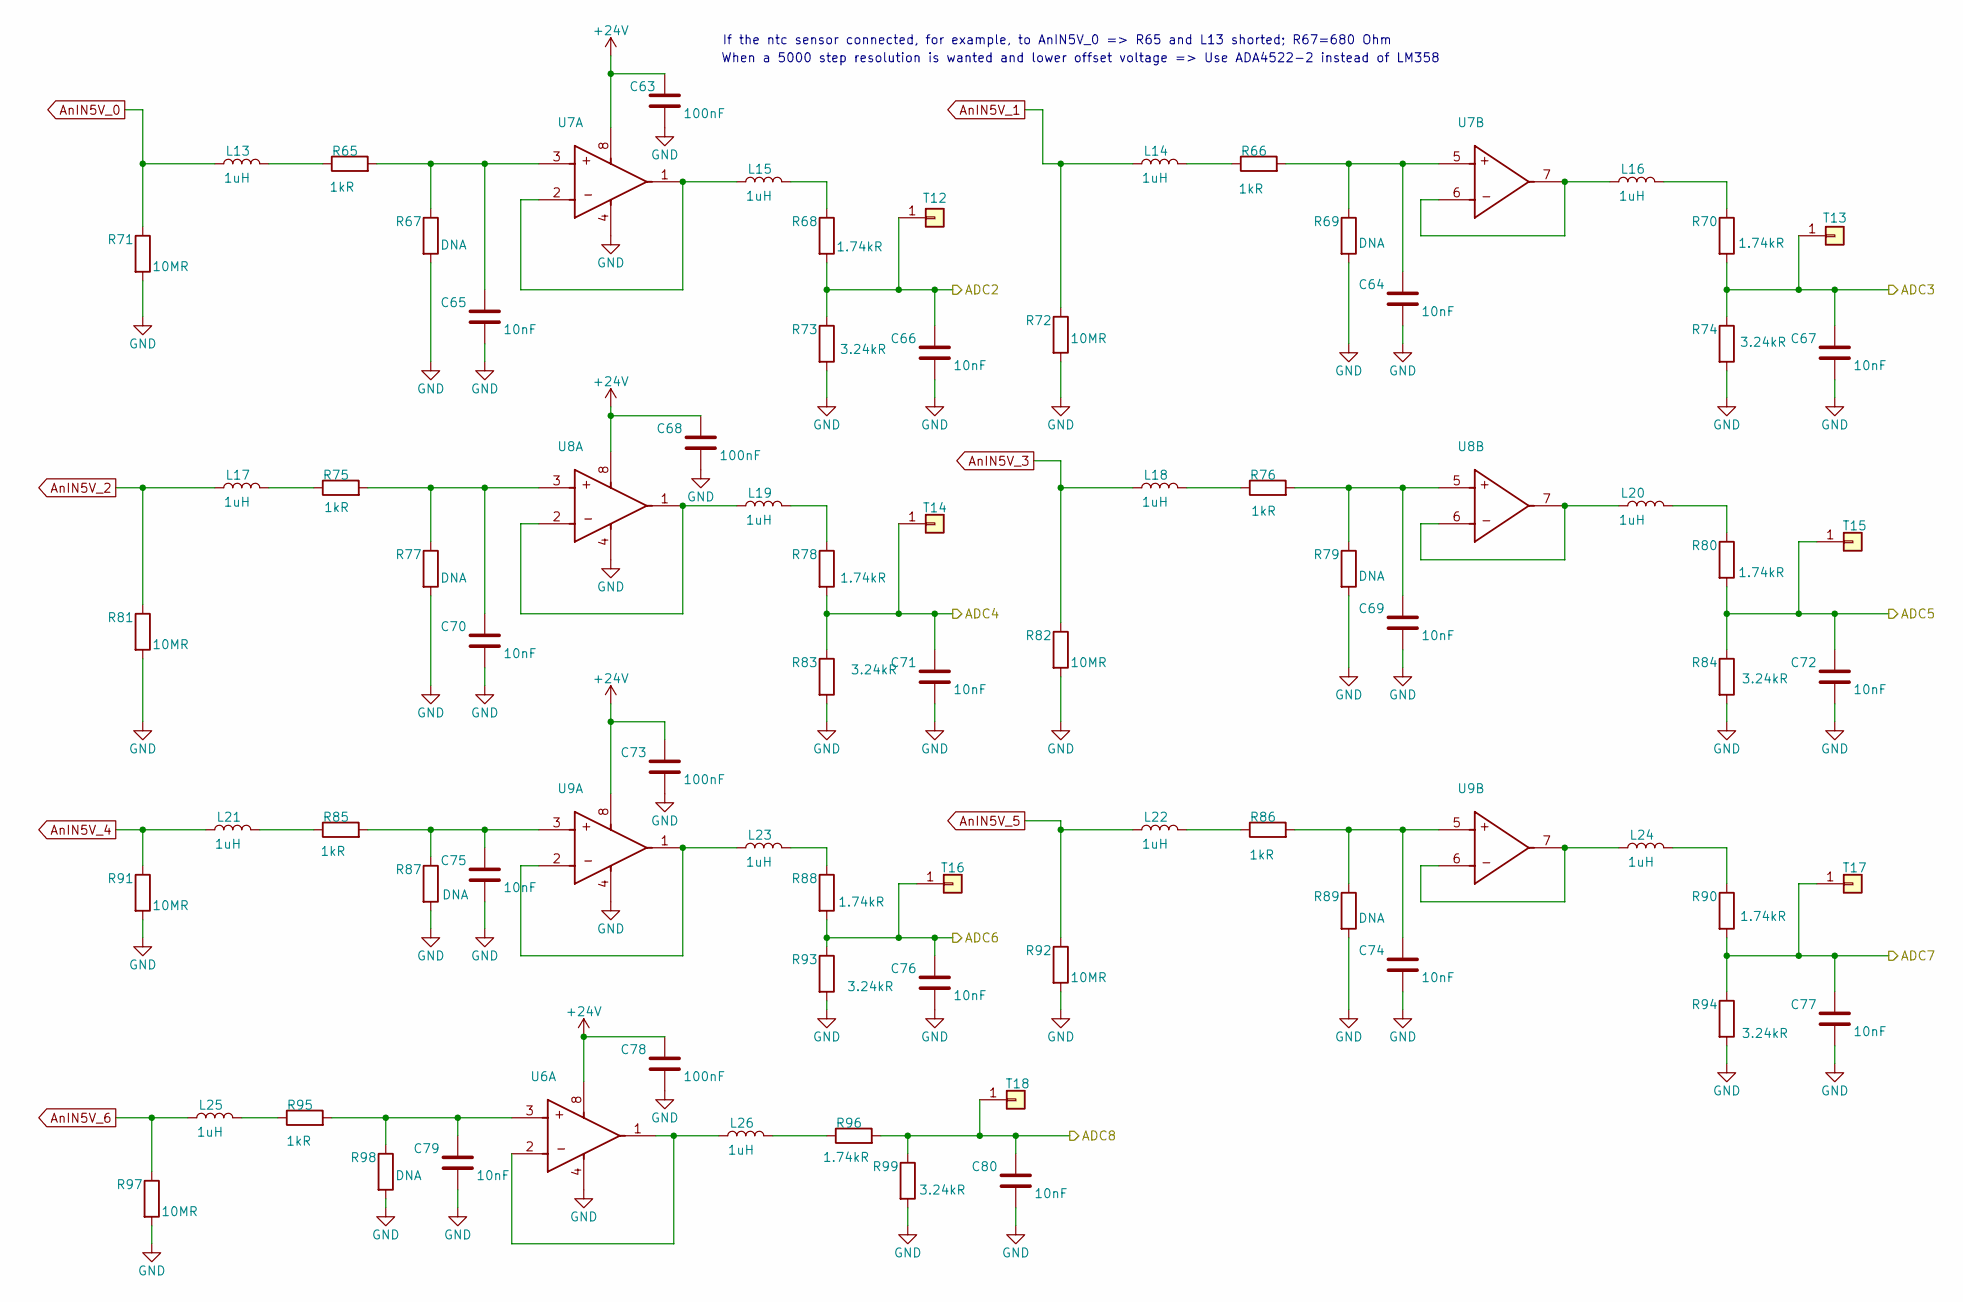
[picture p56: schematic AnalogIn5V.kicad_sch, Filters for 5V analog signal]

Parts:
C63, C68, C73, C78: 100nF; C_0805_2012Metric_Pad1.18x1.45mm_HandSolder; TOLERANCE (FILL IN AS +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 10%
C64, C65, C66, C67, C69, C70, C71, C72, C74, C75, C76, C77, C79, C80: 10nF; C_0805_2012Metric_Pad1.18x1.45mm_HandSolder; TOLERANCE (FILL IN AS +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 10%
L13, L14, L15, L16, L17, L18, L19, L20, L21, L22, L23, L24, L25, L26: 1uH; L_0805_2012Metric_Pad1.15x1.40mm_HandSolder; TOLERANCE 30%; CURRENT RATING 900mA
R65, R66, R75, R76, R85, R86, R95: 1kR; R_0805_2012Metric_Pad1.20x1.40mm_HandSolder
R67, R69, R77, R79, R87, R89, R98: DNA; R_0805_2012Metric_Pad1.20x1.40mm_HandSolder; PART NUMBER CRCW0805680RFKEA
R68, R70, R78, R80, R88, R90, R96: 1.74kR; R_0805_2012Metric_Pad1.20x1.40mm_HandSolder
R71, R72, R81, R82, R91, R92, R97: 10MR; R_0805_2012Metric_Pad1.20x1.40mm_HandSolder; POWER RATING 125mW; VOLTAGE RATING (DC) 150V
R73, R74, R83, R84, R93, R94, R99: 3.24kR; R_0805_2012Metric_Pad1.20x1.40mm_HandSolder
T12, T13, T14, T15, T16, T17, T18: Conn_01x01; TestPoint_THTPad_D1.5mm_Drill0.7mm
U6, U7, U8, U9: LM358BAIDR; FP-D0008A-IPC_A

Connections:
+24V: C63.1, C68.1, C73.1, C78.1, U6.8 (V+), U7.8 (V+), U8.8 (V+), U9.8 (V+); also elsewhere on the board
/AnalogNode/ADC2: C66.1, R68.2, R73.1, T12.1; also elsewhere on the board
/AnalogNode/ADC3: C67.1, R70.2, R74.1, T13.1; also elsewhere on the board
/AnalogNode/ADC4: C71.1, R78.2, R83.1, T14.1; also elsewhere on the board
/AnalogNode/ADC5: C72.1, R80.2, R84.1, T15.1; also elsewhere on the board
/AnalogNode/ADC6: C76.1, R88.2, R93.1, T16.1; also elsewhere on the board
/AnalogNode/ADC7: C77.1, R90.2, R94.1, T17.1; also elsewhere on the board
/AnalogNode/ADC8: C80.1, R96.2, R99.1, T18.1; also elsewhere on the board
AnIN5V_0: L13.1, R71.1; also elsewhere on the board
AnIN5V_1: L14.1, R72.1; also elsewhere on the board
AnIN5V_2: L17.1, R81.1; also elsewhere on the board
AnIN5V_3: L18.1, R82.1; also elsewhere on the board
AnIN5V_4: L21.1, R91.1; also elsewhere on the board
AnIN5V_5: L22.1, R92.1; also elsewhere on the board
AnIN5V_6: L25.1, R97.1; also elsewhere on the board
GND: C63.2, C64.2, C65.2, C66.2, C67.2, C68.2, C69.2, C70.2, C71.2, C72.2, C73.2, C74.2, C75.2, C76.2, C77.2, C78.2, C79.2, C80.2, R67.2, R69.2, R71.2, R72.2, R73.2, R74.2, R77.2, R79.2, R81.2, R82.2, R83.2, R84.2, R87.2, R89.2, R91.2, R92.2, R93.2, R94.2, R97.2, R98.2, R99.2, U6.4 (V-), U7.4 (V-), U8.4 (V-), U9.4 (V-); also elsewhere on the board
unnamed: L13.2, R65.1
unnamed: L14.2, R66.1
unnamed: L15.2, R68.1
unnamed: L16.2, R70.1
unnamed: L17.2, R75.1
unnamed: L18.2, R76.1
unnamed: L19.2, R78.1
unnamed: L20.2, R80.1
unnamed: L21.2, R85.1
unnamed: L22.2, R86.1
unnamed: L23.2, R88.1
unnamed: L24.2, R90.1
unnamed: L25.2, R95.1
unnamed: L26.2, R96.1
unnamed: C79.1, R95.2, R98.1, U6.3 (IN1+)
unnamed: L26.1, U6.1 (OUT1), U6.2 (IN1-)
unnamed: C65.1, R65.2, R67.1, U7.3 (IN1+)
unnamed: L15.1, U7.1 (OUT1), U7.2 (IN1-)
unnamed: C64.1, R66.2, R69.1, U7.5 (IN2+)
unnamed: L16.1, U7.6 (IN2-), U7.7 (OUT2)
unnamed: C70.1, R75.2, R77.1, U8.3 (IN1+)
unnamed: L19.1, U8.1 (OUT1), U8.2 (IN1-)
unnamed: C69.1, R76.2, R79.1, U8.5 (IN2+)
unnamed: L20.1, U8.6 (IN2-), U8.7 (OUT2)
unnamed: C75.1, R85.2, R87.1, U9.3 (IN1+)
unnamed: L23.1, U9.1 (OUT1), U9.2 (IN1-)
unnamed: C74.1, R86.2, R89.1, U9.5 (IN2+)
unnamed: L24.1, U9.6 (IN2-), U9.7 (OUT2)

Notes on the sheet:
When a 5000 step resolution is wanted and lower offset voltage => Use ADA4522-2 instead of LM358
If the ntc sensor connected, for example, to AnIN5V_0 => R65 and L13 shorted; R67=680 Ohm

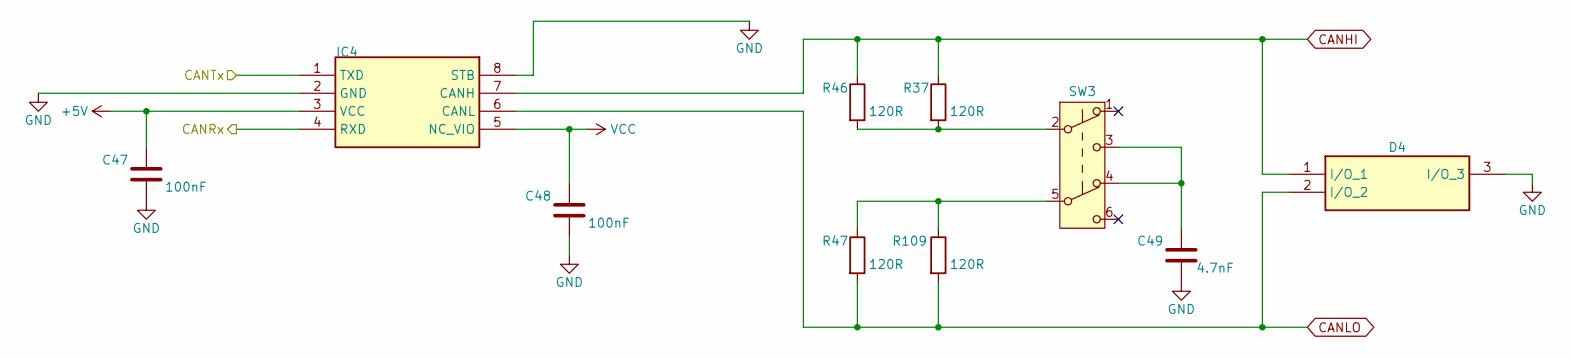
[picture p57: schematic CAN_AnalogNode.kicad_sch, CAN for Analog Node]

Parts:
C47, C48: 100nF; C_0805_2012Metric_Pad1.18x1.45mm_HandSolder; TOLERANCE (FILL IN AS +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 10%
C49: 4.7nF; C_0805_2012Metric_Pad1.18x1.45mm_HandSolder; TOLERANCE (FILL IN AS +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 10%
D4: ESDCAN24-2BLY; SOT95P255X125-3N; Mouser Part Number 511-ESDCAN24-2BLY
IC4: TCAN1462VDRQ1; SOIC127P600X175-8N; MANUFACTURER_PART_NUMBER TCAN1462VDRQ1; MOUSER PART NUMBER 595-TCAN1462VDRQ1
R37, R46, R47, R109: 120R; R_0805_2012Metric_Pad1.20x1.40mm_HandSolder
SW3: CAS-220TB1; SOP175P560X250-6N

Connections:
+5V: C47.1, IC4.3 (VCC); also elsewhere on the board
/AnalogNode/CANRx: IC4.4 (RXD); also elsewhere on the board
/AnalogNode/CANTx: IC4.1 (TXD); also elsewhere on the board
CANHI: D4.1 (I/O), IC4.7 (CANH), R37.1, R46.1; also elsewhere on the board
CANLO: D4.2 (I/O), IC4.6 (CANL), R47.2, R109.2; also elsewhere on the board
GND: C47.2, C48.2, C49.2, D4.3 (I/O), IC4.2 (GND), IC4.8 (STB); also elsewhere on the board
unnamed: C49.1, SW3.3 (C), SW3.4 (A)
unnamed: R37.2, R46.2, SW3.2 (B)
unnamed: R47.1, R109.1, SW3.5 (B)
VCC: C48.1, IC4.5 (NC_VIO); also elsewhere on the board

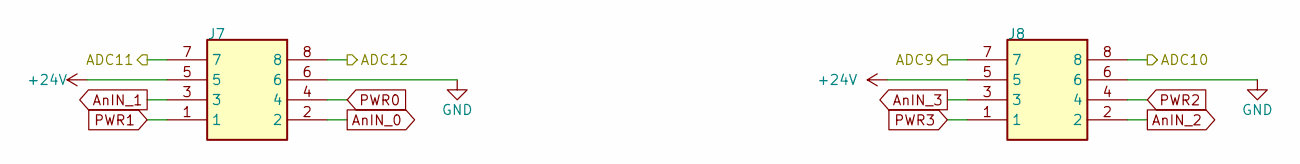
[picture p58: schematic AnalogInPlus.kicad_sch, Additional Connections for Filters]

Parts:
J7, J8: HLE-104-02-L-DV-BE-A-P-TR; HLE-104-02-XXX-DV-BE-A-P-TR; MANUFACTURER_PART_NUMBER HLE-104-02-L-DV-BE-A-P-TR

Connections:
+24V: J7.5, J8.5; also elsewhere on the board
/AnalogNode/ADC9: J8.7; also elsewhere on the board
/AnalogNode/ADC10: J8.8; also elsewhere on the board
/AnalogNode/ADC11: J7.7; also elsewhere on the board
/AnalogNode/ADC12: J7.8; also elsewhere on the board
AnIN_0: J7.2; also elsewhere on the board
AnIN_1: J7.3; also elsewhere on the board
AnIN_2: J8.2; also elsewhere on the board
AnIN_3: J8.3; also elsewhere on the board
GND: J7.6, J8.6; also elsewhere on the board
PWR0: J7.4; also elsewhere on the board
PWR1: J7.1; also elsewhere on the board
PWR2: J8.4; also elsewhere on the board
PWR3: J8.1; also elsewhere on the board

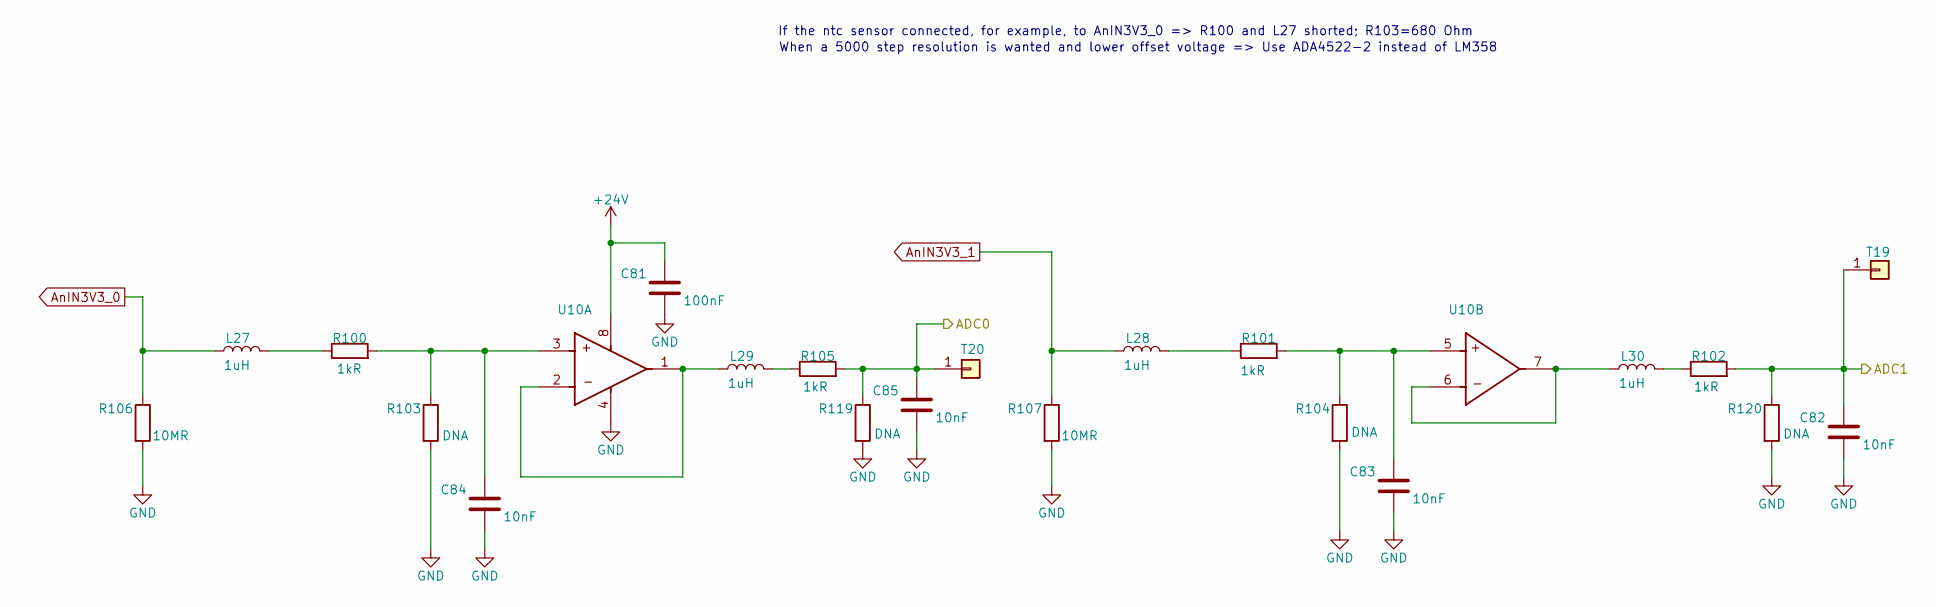
[picture p59: schematic AnalogIn3V3.kicad_sch, Filters for 3V3 analog signal]

Parts:
C81: 100nF; C_0805_2012Metric_Pad1.18x1.45mm_HandSolder; TOLERANCE (FILL IN AS +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 10%
C82, C83, C84, C85: 10nF; C_0805_2012Metric_Pad1.18x1.45mm_HandSolder; TOLERANCE (FILL IN AS +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 10%
L27, L28, L29, L30: 1uH; L_0805_2012Metric_Pad1.15x1.40mm_HandSolder; TOLERANCE 30%; CURRENT RATING 900mA
R100, R101, R102, R105: 1kR; R_0805_2012Metric_Pad1.20x1.40mm_HandSolder
R103, R104, R119, R120: DNA; R_0805_2012Metric_Pad1.20x1.40mm_HandSolder; PART NUMBER CRCW0805680RFKEA
R106, R107: 10MR; R_0805_2012Metric_Pad1.20x1.40mm_HandSolder; POWER RATING 125mW; VOLTAGE RATING (DC) 150V
T19, T20: Conn_01x01; TestPoint_THTPad_D1.5mm_Drill0.7mm
U10: LM358BAIDR; FP-D0008A-IPC_A

Connections:
+24V: C81.1, U10.8 (V+); also elsewhere on the board
/AnalogNode/ADC0: C85.1, R105.2, R119.1, T20.1; also elsewhere on the board
/AnalogNode/ADC1: C82.1, R102.2, R120.1, T19.1; also elsewhere on the board
AnIN3V3_0: L27.1, R106.1; also elsewhere on the board
AnIN3V3_1: L28.1, R107.1; also elsewhere on the board
GND: C81.2, C82.2, C83.2, C84.2, C85.2, R103.2, R104.2, R106.2, R107.2, R119.2, R120.2, U10.4 (V-); also elsewhere on the board
unnamed: L27.2, R100.1
unnamed: L28.2, R101.1
unnamed: L29.2, R105.1
unnamed: L30.2, R102.1
unnamed: C84.1, R100.2, R103.1, U10.3 (IN1+)
unnamed: L29.1, U10.1 (OUT1), U10.2 (IN1-)
unnamed: C83.1, R101.2, R104.1, U10.5 (IN2+)
unnamed: L30.1, U10.6 (IN2-), U10.7 (OUT2)

Notes on the sheet:
If the ntc sensor connected, for example, to AnIN3V3_0 => R100 and L27 shorted; R103=680 Ohm
When a 5000 step resolution is wanted and lower offset voltage => Use ADA4522-2 instead of LM358

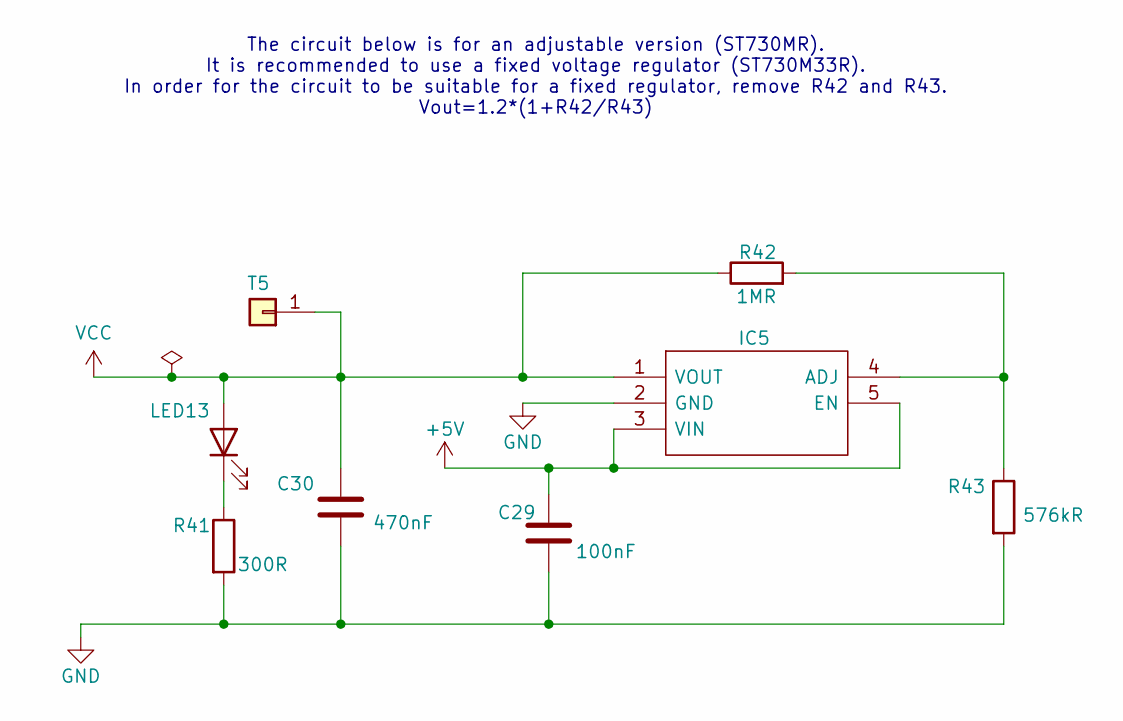
[picture p60: schematic Power3V3.kicad_sch, Power 3V3]

Parts:
C29: 100nF; C_0805_2012Metric_Pad1.18x1.45mm_HandSolder; TOLERANCE (FILL IN AS +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 10%
C30: 470nF; C_0805_2012Metric_Pad1.18x1.45mm_HandSolder
IC5: ST730MR; SOT95P280X145-5N; Mouser Part Number 511-ST730MR
LED13: SML-210YTT86M; LED_0805_2012Metric_Pad1.15x1.40mm_HandSolder; MANUFACTURER_PART_NUMBER SML-210YTT86M
R41: 300R; R_0805_2012Metric_Pad1.20x1.40mm_HandSolder; POWER RATING 400mW; TOLERANCE 5%
R42: 1MR; R_0805_2012Metric_Pad1.20x1.40mm_HandSolder
R43: 576kR; R_0805_2012Metric_Pad1.20x1.40mm_HandSolder
T5: Conn_01x01; TestPoint_THTPad_D1.5mm_Drill0.7mm

Connections:
+5V: C29.1, IC5.3 (VIN), IC5.5 (EN); also elsewhere on the board
GND: C29.2, C30.2, IC5.2 (GND), R41.2, R43.2; also elsewhere on the board
unnamed: IC5.4 (ADJ), R42.2, R43.1
unnamed: LED13.1 (K), R41.1
VCC: C30.1, IC5.1 (VOUT), LED13.2 (A), R42.1, T5.1; also elsewhere on the board

Notes on the sheet:
The circuit below is for an adjustable version (ST730MR). It is recommended to use a fixed voltage regulator (ST730M33R). In order for the circuit to be suitable for a fixed regulator, remove R42 and R43. Vout=1.2*(1+R42/R43)

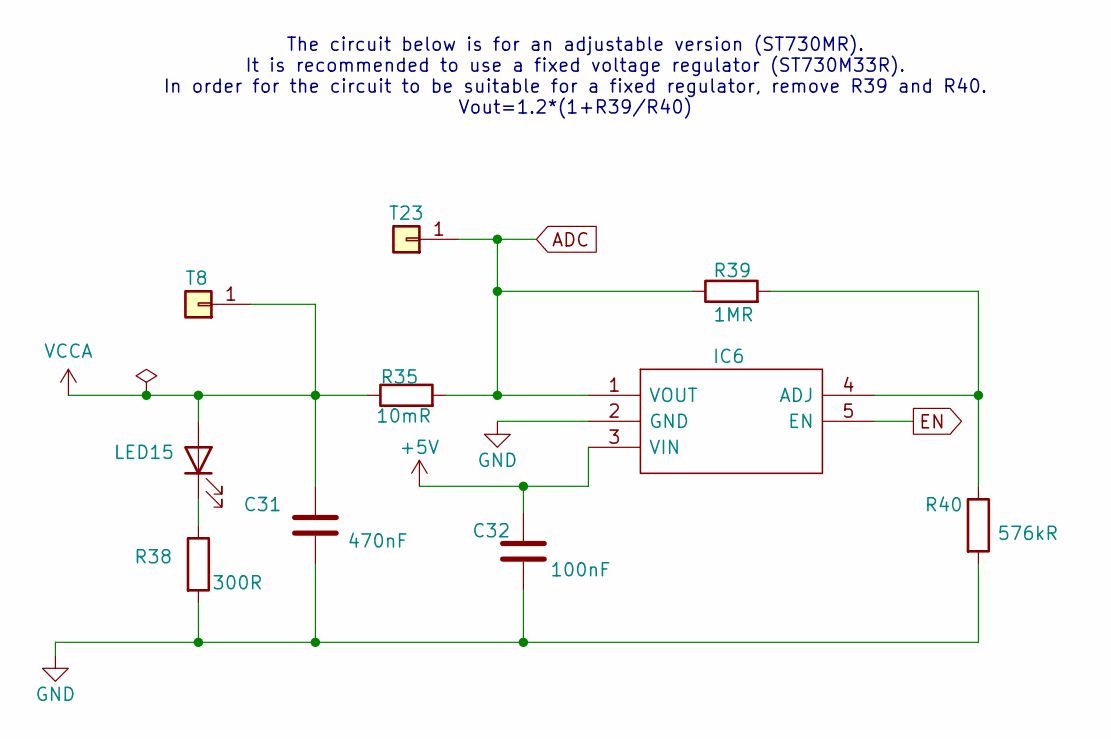
[picture p61: schematic Power3V3_An.kicad_sch, Power 3V3 Analog]

Parts:
C31: 470nF; C_0805_2012Metric_Pad1.18x1.45mm_HandSolder
C32: 100nF; C_0805_2012Metric_Pad1.18x1.45mm_HandSolder; TOLERANCE (FILL IN AS +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 10%
IC6: ST730MR; SOT95P280X145-5N; Mouser Part Number 511-ST730MR
LED15: 150080BS75000; LED_0805_2012Metric_Pad1.15x1.40mm_HandSolder; MANUFACTURER_PART_NUMBER SZYY0805B
R35: 10mR; R_0805_2012Metric_Pad1.20x1.40mm_HandSolder; TOLERANCE 1%
R38: 300R; R_0805_2012Metric_Pad1.20x1.40mm_HandSolder; POWER RATING 400mW; TOLERANCE 5%
R39: 1MR; R_0805_2012Metric_Pad1.20x1.40mm_HandSolder
R40: 576kR; R_0805_2012Metric_Pad1.20x1.40mm_HandSolder
T8, T23: Conn_01x01; TestPoint_THTPad_D1.5mm_Drill0.7mm

Connections:
+5V: C32.1, IC6.3 (VIN); also elsewhere on the board
ADC: IC6.1 (VOUT), R35.2, R39.1, T23.1; also elsewhere on the board
EN: IC6.5 (EN); also elsewhere on the board
GND: C31.2, C32.2, IC6.2 (GND), R38.2, R40.2; also elsewhere on the board
unnamed: IC6.4 (ADJ), R39.2, R40.1
unnamed: LED15.1 (K), R38.1
VCCA: C31.1, LED15.2 (A), R35.1, T8.1; also elsewhere on the board

Notes on the sheet:
The circuit below is for an adjustable version (ST730MR). It is recommended to use a fixed voltage regulator (ST730M33R). In order for the circuit to be suitable for a fixed regulator, remove R39 and R40. Vout=1.2*(1+R39/R40)

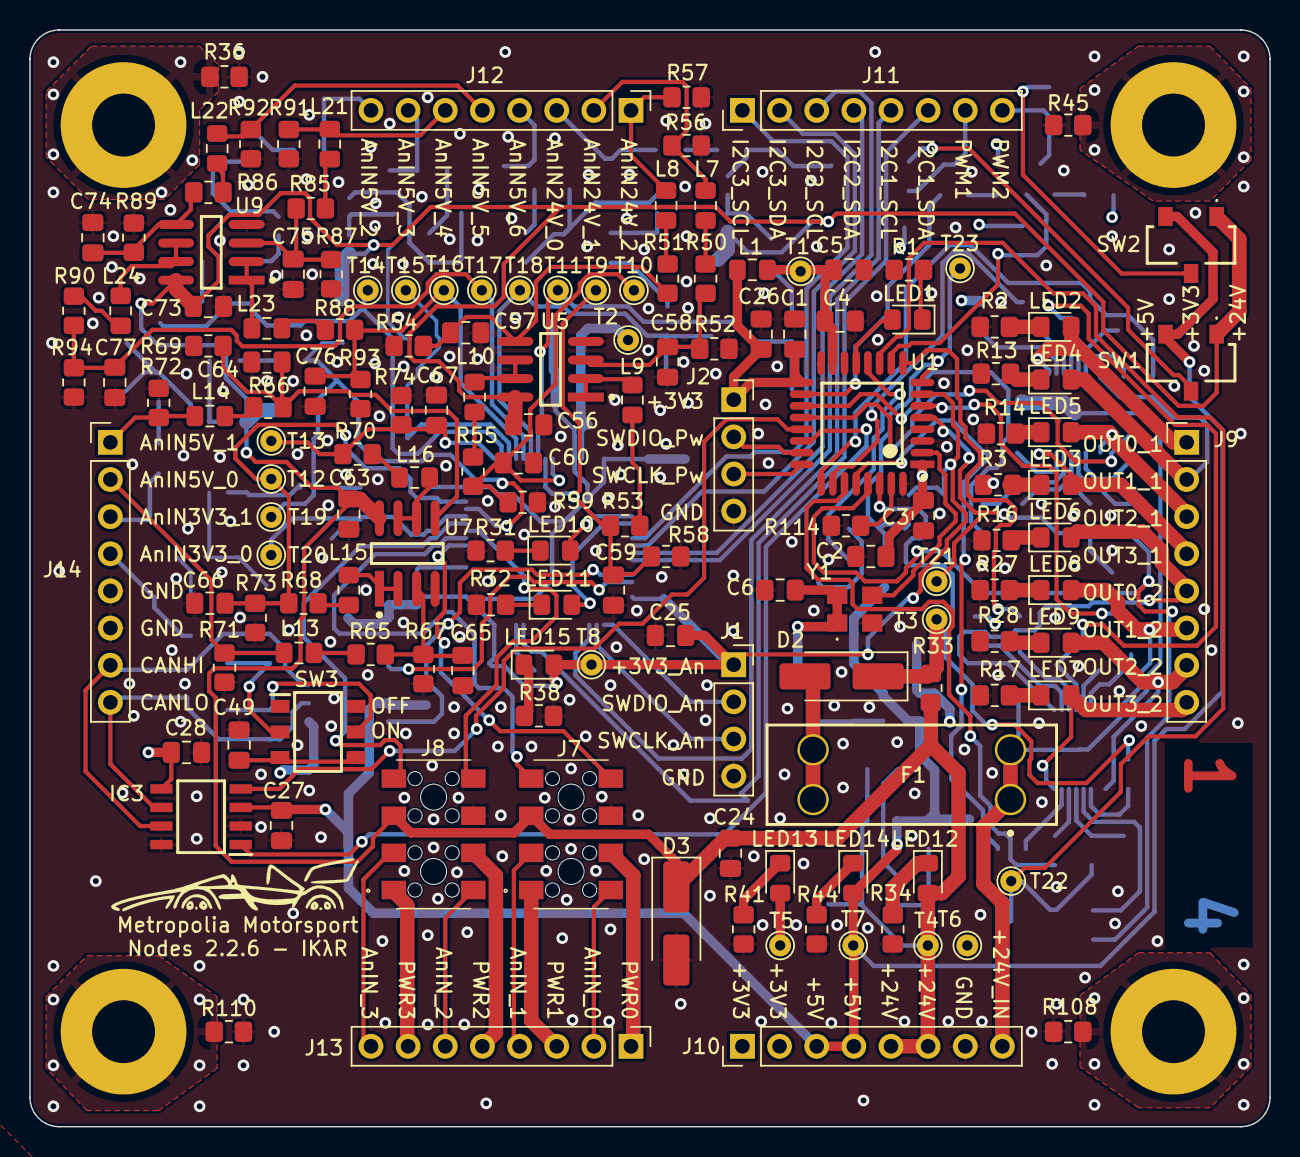
[picture p62: board Nodes.kicad_pcb from above]

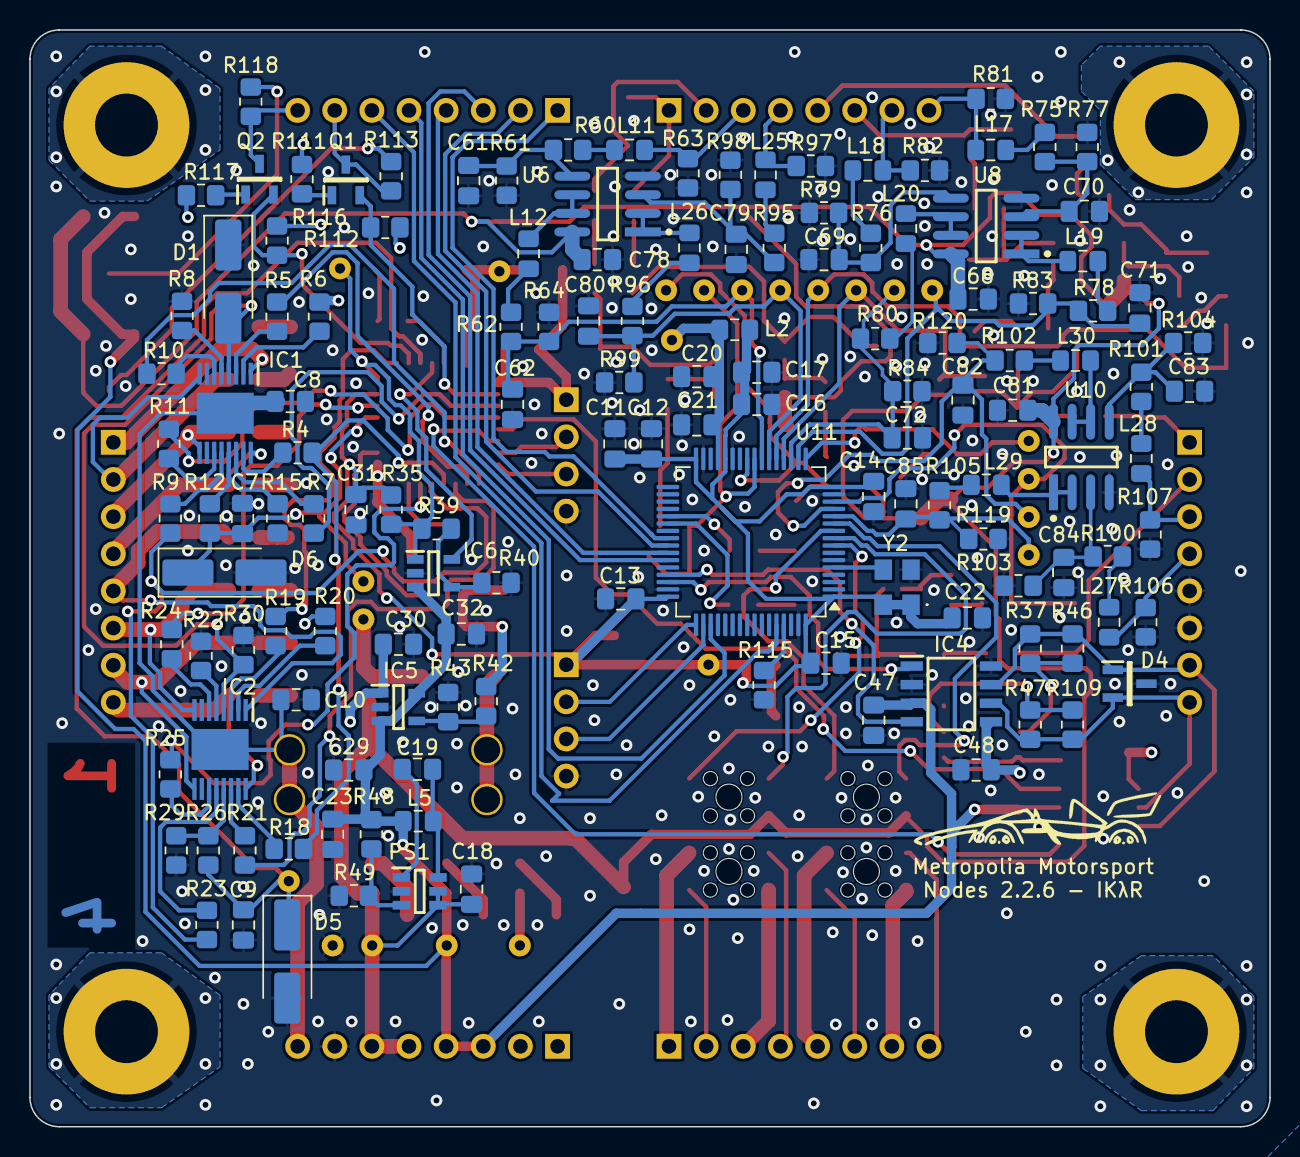
[picture p63: board Nodes.kicad_pcb from below]

Board: 4 copper layers, 84.8 x 75.0 mm, 293 parts (138 on the bottom side), 193 nets.

Other parts of the board:
C18: 2.2uF; C_0805_2012Metric_Pad1.18x1.45mm_HandSolder
C19: 100nF; C_0805_2012Metric_Pad1.18x1.45mm_HandSolder
C23: 10uF; C_0805_2012Metric_Pad1.18x1.45mm_HandSolder
L5: 4.7uH; L_0805_2012Metric_Pad1.15x1.40mm_HandSolder
LED14: SML-H12P8TT86; LED_0805_2012Metric_Pad1.15x1.40mm_HandSolder
PS1: LMR50410YFQDBVRQ1; SOT95P280X145-6N
R44: 1kR; R_0805_2012Metric_Pad1.20x1.40mm_HandSolder
R48: 88.7kR; R_0805_2012Metric_Pad1.20x1.40mm_HandSolder
R49: 22.1kR; R_0805_2012Metric_Pad1.20x1.40mm_HandSolder
T7: Conn_01x01; TestPoint_THTPad_D1.5mm_Drill0.7mm

Their connections:
+5V: C23.1, L5.2, LED14.2 (A), R48.2, T7.1; also elsewhere on the board
+24V: C18.1, PS1.4 (EN), PS1.5 (VIN); also elsewhere on the board
GND: C18.2, C23.2, PS1.2 (GND), R44.2, R49.2; also elsewhere on the board
unnamed: LED14.1 (K), R44.1
unnamed: C19.1, PS1.1 (CB)
unnamed: PS1.3 (FB), R48.1, R49.1
unnamed: C19.2, L5.1, PS1.6 (SW)
