MetropoliaMotorsport/Nodes/(commit log)

2024-06-08 First commit v2.11
    [AnalogIn24V.kicad_sch, AnalogIn3V3.kicad_sch, AnalogIn5V.kicad_sch, AnalogInPlus.kicad_sch, AnalogNode.kicad_sch, CAN_AnalogNode.kicad_sch, CAN_PowerNode.kicad_sch, Nodes.kicad_sch]
2024-06-13 Nodes v2.1.2
    -Added power switch
    - Changed footprints to handsolder for small components
    - Can numbering changed 1->2 and 2->1
    - Some components have been changed
    - Some small changes with texts
    - Improved BOM
    - PDF added for easier access
    - Added switch for CAN termination
    - Improved grounding with vias
    - And other small improvements
    [AnalogIn24V.kicad_sch, AnalogIn3V3.kicad_sch, AnalogIn5V.kicad_sch, AnalogInPlus.kicad_sch, AnalogNode.kicad_sch, CAN_AnalogNode.kicad_sch, CAN_PowerNode.kicad_sch, Nodes.kicad_sch]
2024-06-17 Nodes v2.1.2 Improved
    - Improved schematic design
    - Added two 4.7 uF caps according to the datasheets of the microchips
    - Other small changes
    [AnalogIn24V.kicad_sch, AnalogIn3V3.kicad_sch, AnalogIn5V.kicad_sch, AnalogInPlus.kicad_sch, AnalogNode.kicad_sch, CAN_AnalogNode.kicad_sch, CAN_PowerNode.kicad_sch, Nodes.kicad_sch]
2024-06-21 Nodes v2.2
    - This version not compatible with BOB v.2.1.2 and older!
    - Completely new layout design
    - New power supply system with new voltage regulators
    - New microchip STM32G431RBTx for the Analog Node
    - New connection system (instead of 18 pin headers now 8 pin and pins were grouped by functions)
    - Reduced size of the board by 5%
    - Removed power switch for the Analog Node (because this functionality is now provided by a separate voltage regulator. for a more stable voltage)
    - Removable ground from the holes added
    - Layer numbers added
    - Small improvements of the components information were made
    - New oscillator for the Nodes
    - Removed CAN1, so now only one CAN connection due to the capabi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
    [AnalogIn24V.kicad_sch, AnalogIn3V3.kicad_sch, AnalogIn5V.kicad_sch, AnalogInPlus.kicad_sch, AnalogNode.kicad_sch, CAN_AnalogNode.kicad_sch, CAN_PowerNode.kicad_sch, Nodes.kicad_sch]
2024-06-22 Nodes v2.2 Improved
    - J9 connector moved by 0.2 mm to the left
    - Same changes as older version, but, please DO NOT PRINT OLDER V2.2 WITHOUT APPROVE
2024-07-10 Nodes v2.2.2
    - Level-Shifter on PWM1 for 24V applications added
    [CAN_PowerNode.kicad_sch, Nodes.kicad_sch, PWM_24V.kicad_sch, PowerNode.kicad_sch]
2024-07-10 Nodes v2.2.2
    - BOM generated
    - GBR and DRL files generated
    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
    [Nodes-B_Cu.gbr, Nodes-B_Mask.gbr, Nodes-B_Paste.gbr, Nodes-B_Silkscreen.gbr, Nodes-Edge_Cuts.gbr, Nodes-F_Cu.gbr, Nodes-F_Mask.gbr, Nodes-F_Paste.gbr]
2024-08-13 Nodes v2.2.3
    - Added one more PWM Level shifter
    - Controllable amplitude of PWM by switches
    - Added labels
    - Added resistors to solve BOOT issue
    - I2C1 pins changed
    - More GND vias
    - Higher resistance for adjustable voltage regulators
    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
    [AnalogNode.kicad_sch, CAN_AnalogNode.kicad_sch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]
2024-08-30 Nodes v2.2.4
    - Added two Zener Diodes for CS pins of High-Side drivers
    [Nodes-B_Cu.gbr, Nodes-B_Mask.gbr, Nodes-B_Paste.gbr, Nodes-B_Silkscreen.gbr, Nodes-Edge_Cuts.gbr, Nodes-F_Cu.gbr, Nodes-F_Mask.gbr, Nodes-F_Paste.gbr]
2024-09-19 Nodes v2.2.5
    - New High-Side Driver (Same footprint, just new info)
    - Two resistors added for 3V3 Filters, which can be used to implement voltage divider
    [AnalogIn24V.kicad_sch, AnalogIn3V3.kicad_sch, AnalogIn5V.kicad_sch, AnalogNode.kicad_sch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]
2024-10-23 Nodes 2.2.5 Revision 1
    - New LED colour coding
    - Nodes Datasheet added
    [AnalogIn24V.kicad_sch, AnalogIn3V3.kicad_sch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]
2024-12-06 Nodes v2.2.6 Revision 1.1
    - CAN connection mistake for Analog Node was fixed
    - Updated datasheet about CAN
    [AnalogNode.kicad_sch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]
